thecolonel999/Word-Clock/Eagle/eagleUp/eagleUp_Word-Clock_bottom.png

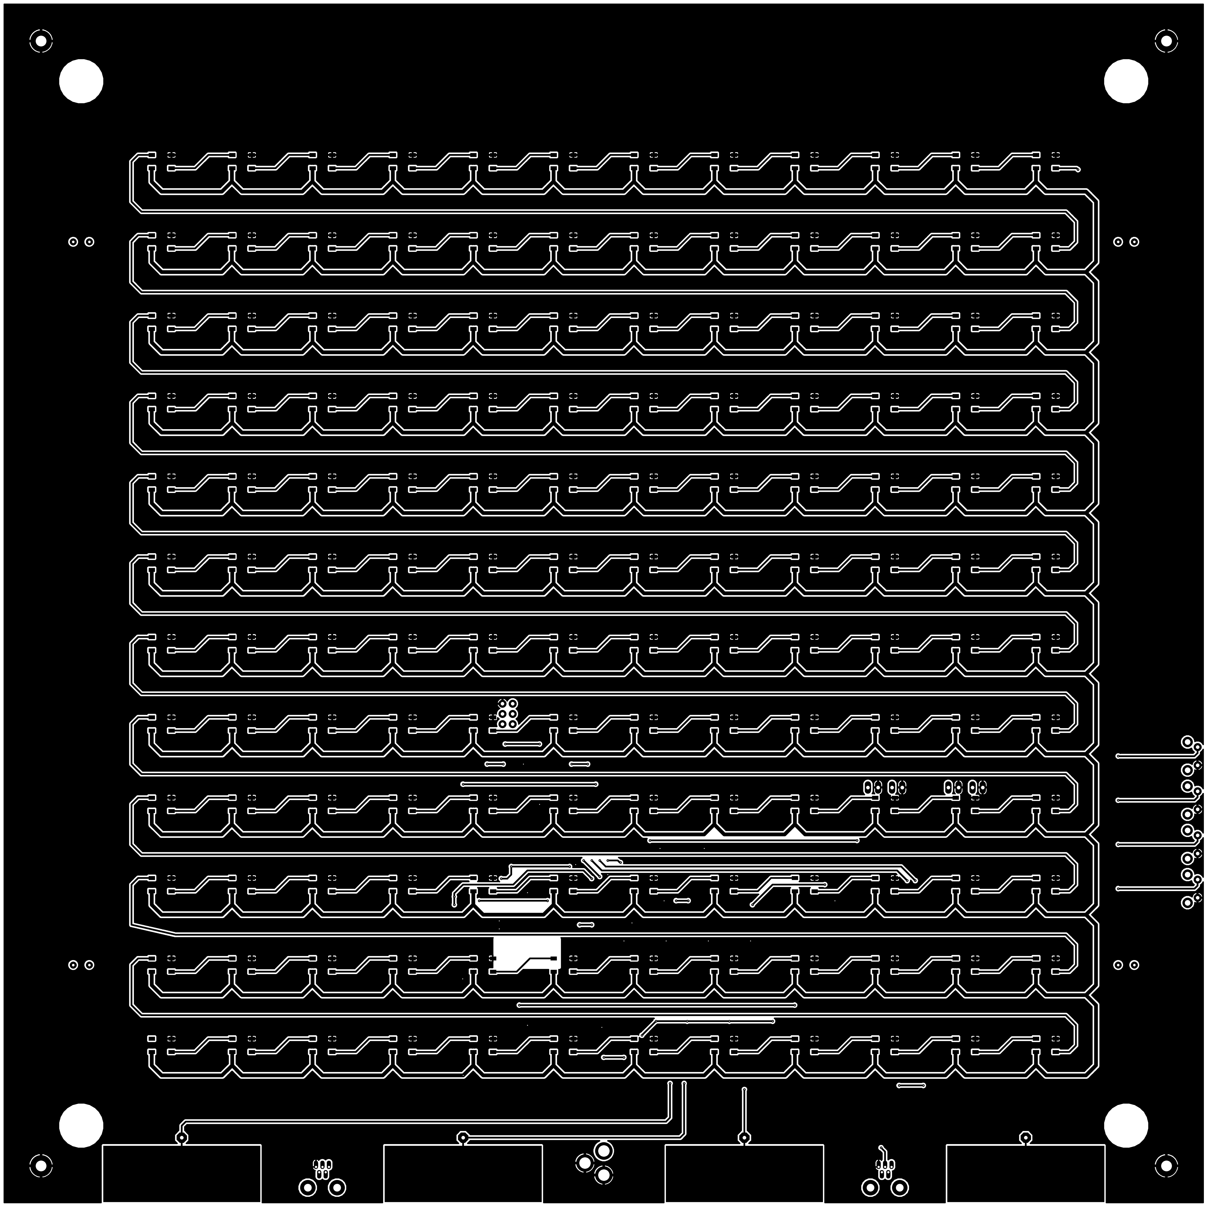
Eagle/eagleUp/eagleUp_Word-Clock_bottom.png
