thecolonel999/Word-Clock/Eagle/eagleUp/eagleUp_Word-Clock_bottom_mask.png

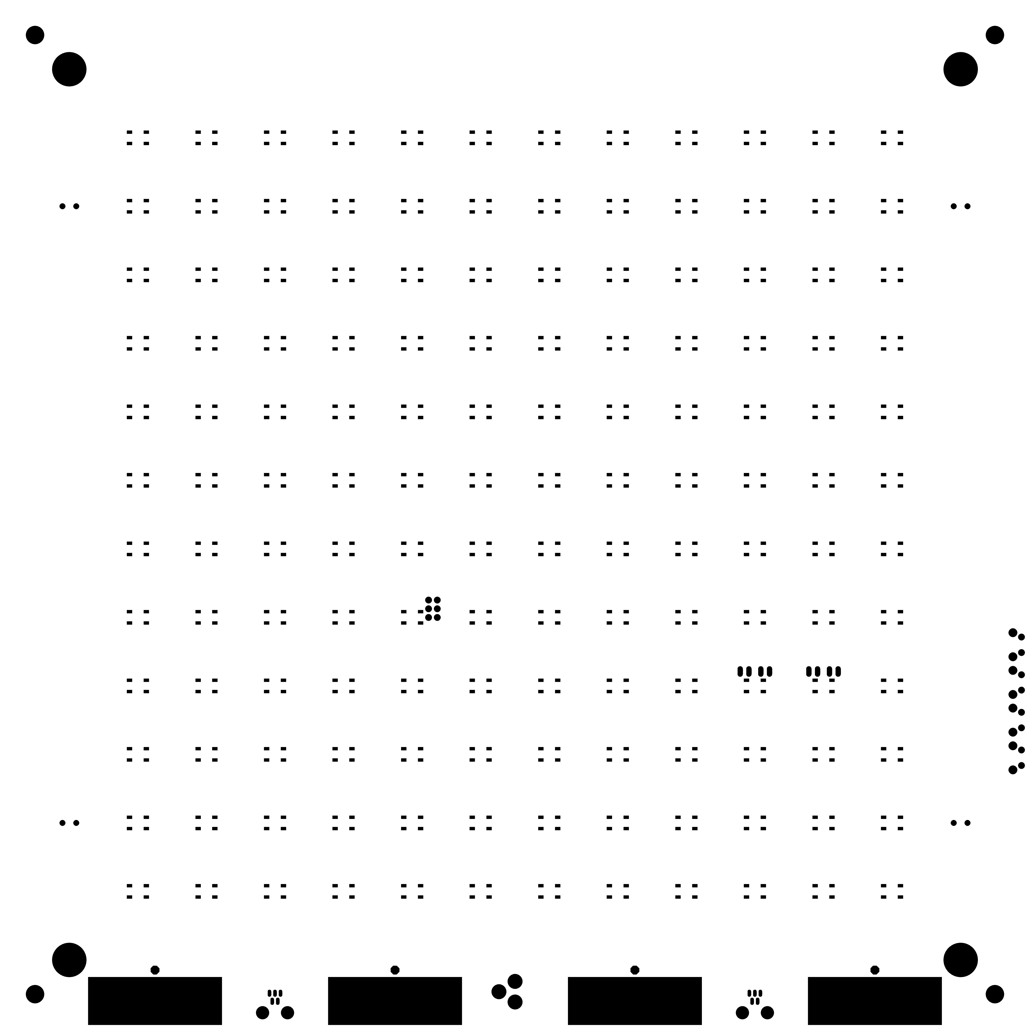
Eagle/eagleUp/eagleUp_Word-Clock_bottom_mask.png
