thecolonel999/Word-Clock/Eagle/eagleUp/eagleUp_Word-Clock_bottom_silk.png

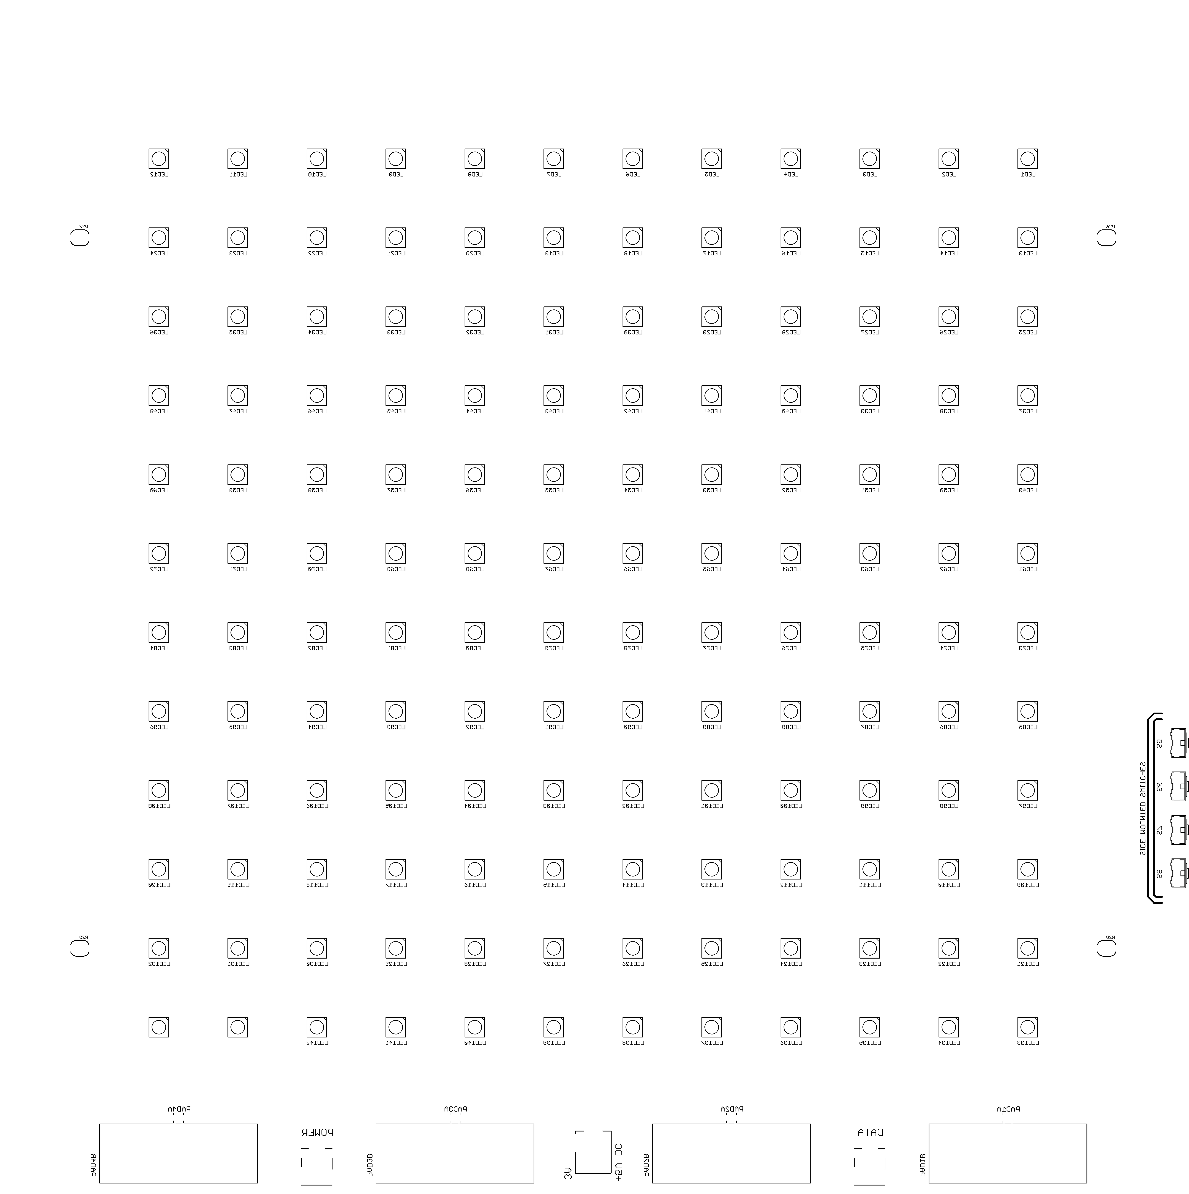
Eagle/eagleUp/eagleUp_Word-Clock_bottom_silk.png
