thecolonel999/Word-Clock/Eagle/eagleUp/eagleUp_Word-Clock_imagesize.png

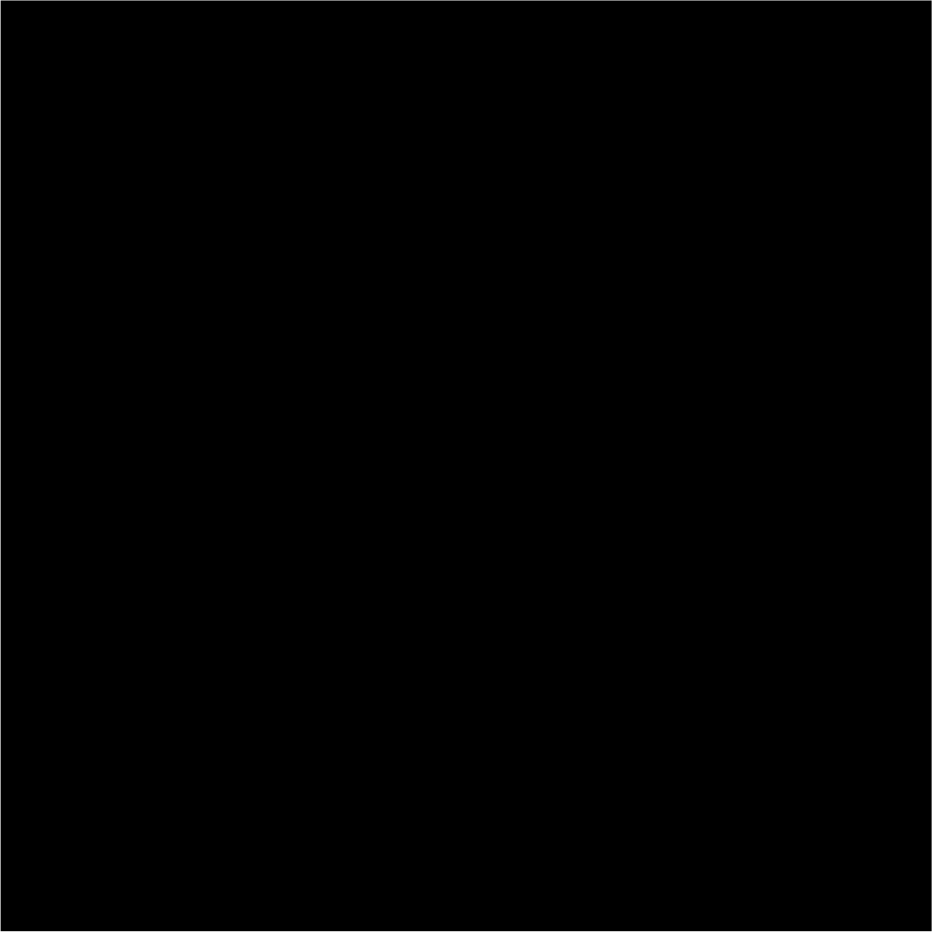
Eagle/eagleUp/eagleUp_Word-Clock_imagesize.png
