thecolonel999/Word-Clock/Eagle/eagleUp/eagleUp_Word-Clock_outline.png

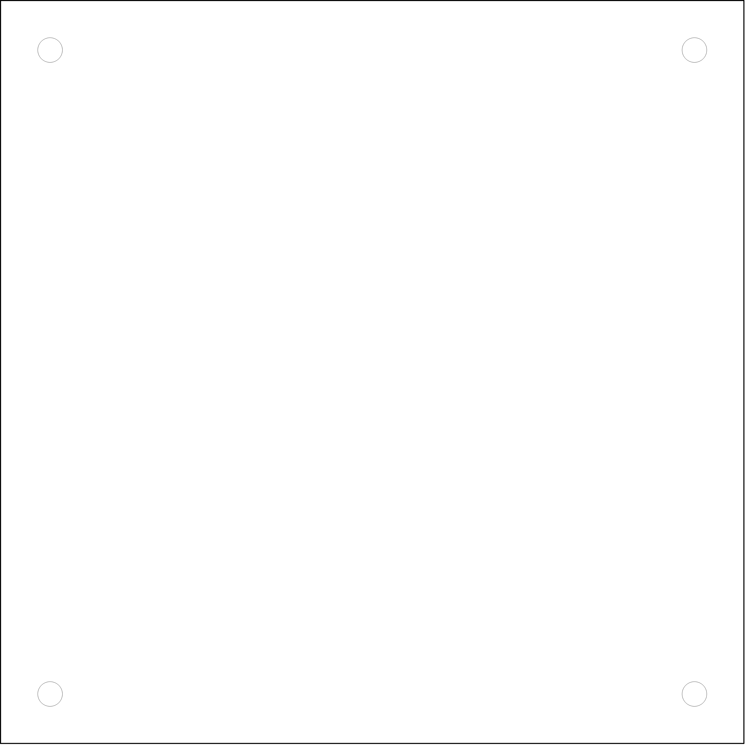
Eagle/eagleUp/eagleUp_Word-Clock_outline.png
