thecolonel999/Word-Clock/Eagle/eagleUp/eagleUp_Word-Clock_top.png

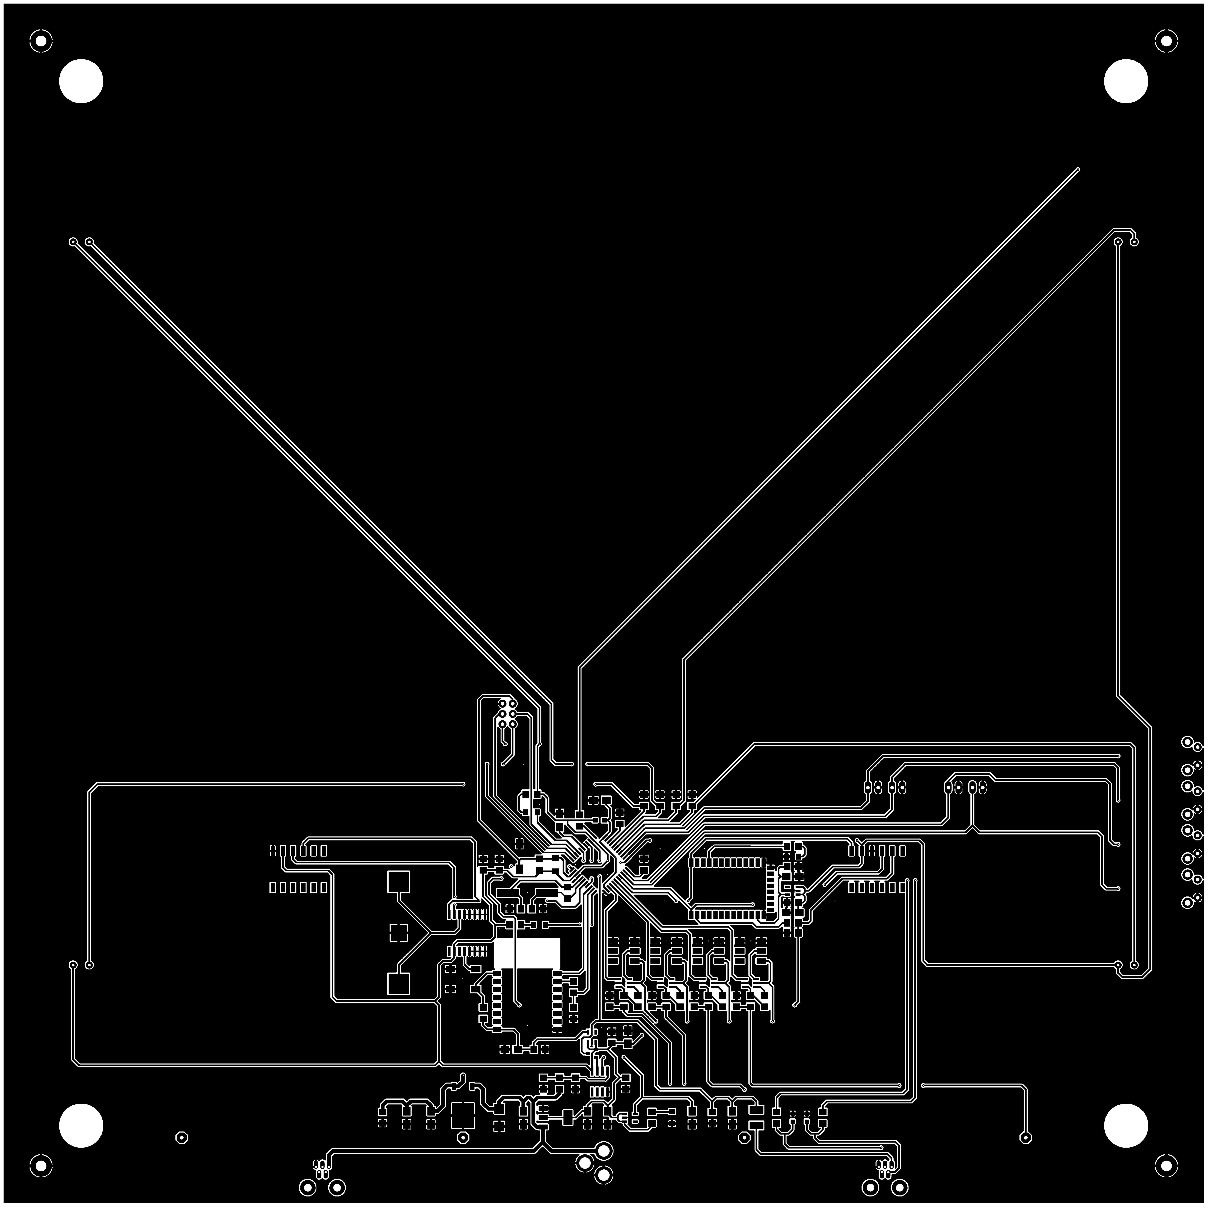
Eagle/eagleUp/eagleUp_Word-Clock_top.png
