thecolonel999/Word-Clock/Eagle/eagleUp/eagleUp_Word-Clock_top_silk.png

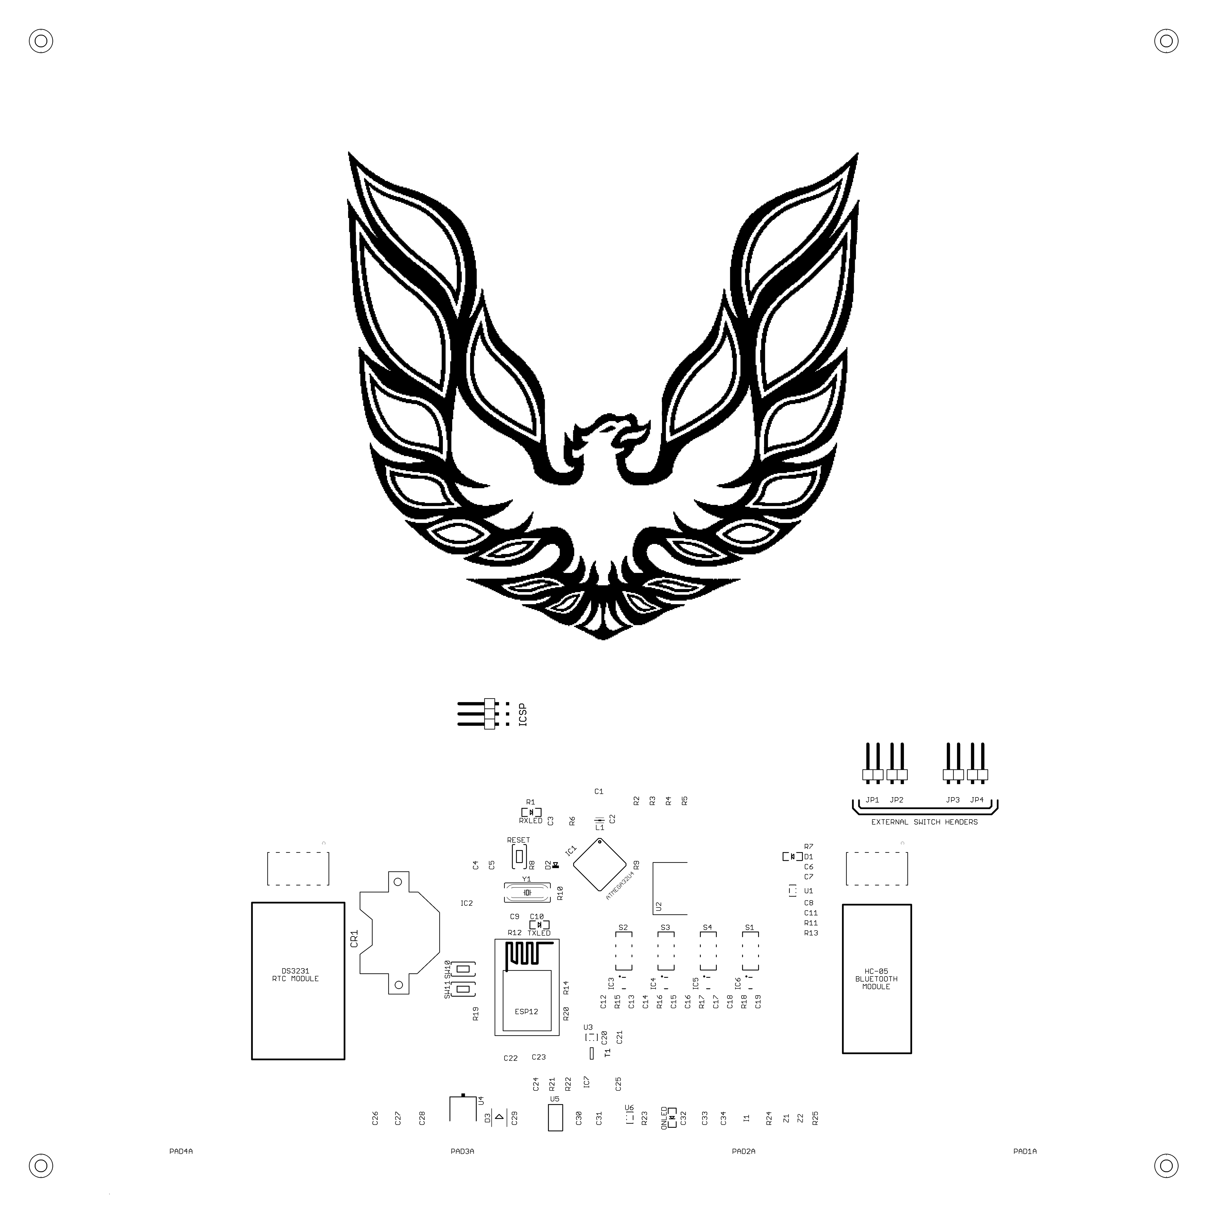
Eagle/eagleUp/eagleUp_Word-Clock_top_silk.png
