thecolonel999/Word-Clock/Sketchup Models/300mm Divider.jpg

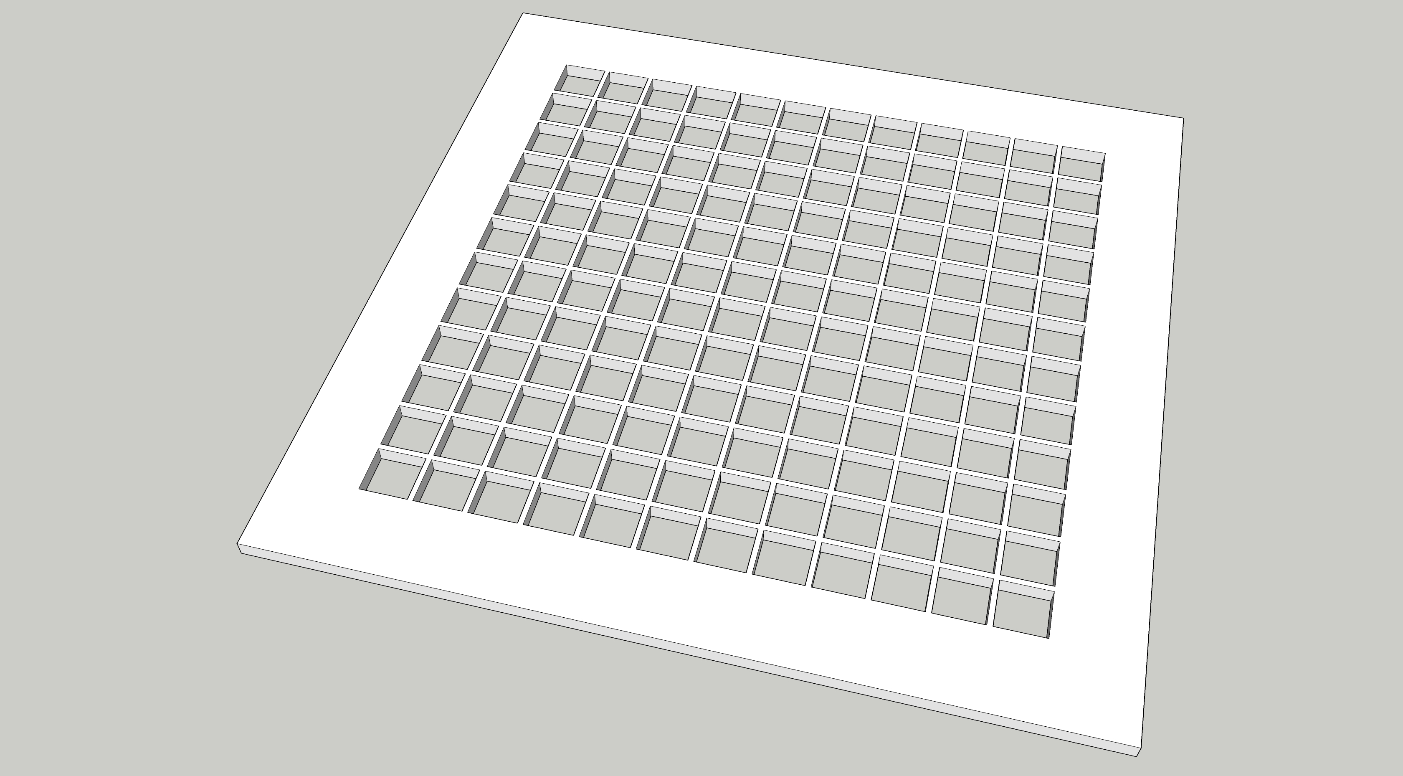
Sketchup Models/300mm Divider.jpg
