thecolonel999/Word-Clock/Vinyl Cutout/Vinyl Cutout V1.0.png

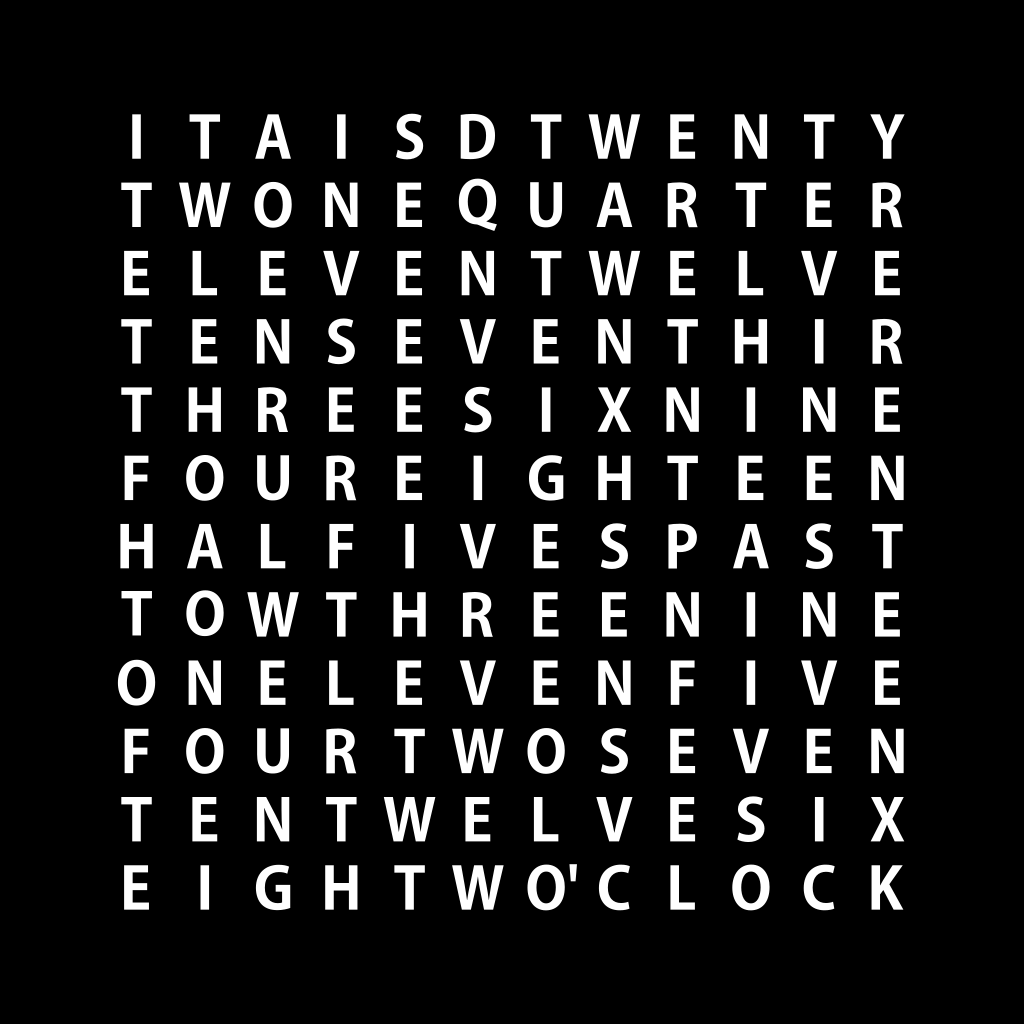
Vinyl Cutout/Vinyl Cutout V1.0.png
