thecolonel999/Word-Clock/Bill of Materials/Word-Clock-BOM.csv

Part | Value | Device | Package | Description | FARNELL | MF | MPN | OC_FARNELL | OC_NEWARK | PROD_ID | VALUE
+5VDC | POWER_JACKPTH | POWER_JACKPTH | POWER_JACK_PTH | Power Jack |  |  |  |  |  | CONN-08197
BLUETOOTH | BLUETOOTH | M06SMD-FEMALE-V2 | 1X06-SMD-FEMALE-V2 | Header 6
C1 | 1uF | CPOL-EUC/6032-28R | C/6032-28R | POLARIZED CAPACITOR, European symbol
C2 | 100n | C-EUC1206 | C1206 | CAPACITOR, European symbol
C3 | 1uF | CPOL-EUC/6032-28R | C/6032-28R | POLARIZED CAPACITOR, European symbol
C4 | 100n | C-EUC1206 | C1206 | CAPACITOR, European symbol
C5 | 100n | C-EUC1206 | C1206 | CAPACITOR, European symbol
C6 | 100n | C-EUC1206 | C1206 | CAPACITOR, European symbol
C7 | 1u | CPOL-EUSMCA | SMC_A | POLARIZED CAPACITOR, European symbol
C8 | 100n | C-EUC1206 | C1206 | CAPACITOR, European symbol
C9 | 22p | C-EUC1206 | C1206 | CAPACITOR, European symbol
C10 | 22p | C-EUC1206 | C1206 | CAPACITOR, European symbol
C11 | 1u | CPOL-EUSMCA | SMC_A | POLARIZED CAPACITOR, European symbol
C12 | 100n | C-EUC1206 | C1206 | CAPACITOR, European symbol
C13 | 100n | C-EUC1206 | C1206 | CAPACITOR, European symbol
C14 | 100n | C-EUC1206 | C1206 | CAPACITOR, European symbol
C15 | 100n | C-EUC1206 | C1206 | CAPACITOR, European symbol
C16 | 100n | C-EUC1206 | C1206 | CAPACITOR, European symbol
C17 | 100n | C-EUC1206 | C1206 | CAPACITOR, European symbol
C18 | 100n | C-EUC1206 | C1206 | CAPACITOR, European symbol
C19 | 100n | C-EUC1206 | C1206 | CAPACITOR, European symbol
C20 | 100n | C-EUC1206 | C1206 | CAPACITOR, European symbol
C21 | 1u | CPOL-EUSMCA | SMC_A | POLARIZED CAPACITOR, European symbol
C22 | 1u | CPOL-EUC/6032-28R | C/6032-28R | POLARIZED CAPACITOR, European symbol
C23 | 100n | C-EUC1206 | C1206 | CAPACITOR, European symbol
C24 | 100n | C-EUC1206 | C1206 | CAPACITOR, European symbol
C25 | 100n | C-EUC1206 | C1206 | CAPACITOR, European symbol
C26 | 100n | C-EUC1206 | C1206 | CAPACITOR, European symbol
C27 | 10u | CPOL-EUC/6032-28R | C/6032-28R | POLARIZED CAPACITOR, European symbol
C28 | 10u | CPOL-EUC/6032-28R | C/6032-28R | POLARIZED CAPACITOR, European symbol
C29 | 10u | CPOL-EUC/6032-28R | C/6032-28R | POLARIZED CAPACITOR, European symbol
C30 | 10u | CPOL-EUC/6032-28R | C/6032-28R | POLARIZED CAPACITOR, European symbol
C31 | 1u | CPOL-EUC/6032-28R | C/6032-28R | POLARIZED CAPACITOR, European symbol
C32 | 1u | CPOL-EUC/6032-28R | C/6032-28R | POLARIZED CAPACITOR, European symbol
C33 | 100n | C-EUC1206 | C1206 | CAPACITOR, European symbol
C34 | 10u | CPOL-EUC/6032-28R | C/6032-28R | POLARIZED CAPACITOR, European symbol
CR1 | CR2032 | CR2032SMT | CR2032-SMD
D1 | BLUE | LED-BLUE1206 | LED-1206 | Blue LEDs for production use |  |  |  |  |  | DIO-09911 | BLUE
D2 | CD1206-S01575 | DIODE-MINIMELF | MINIMELF | DIODE
D3 | M7 | DIODE-SMB | SMB | DIODE
DATA | USBDATA | USBMOLEX | USB-MINIB-THM-MOLEX | USB Connectors
DS1 | DS3231 | M06SMD-FEMALE-V2 | 1X06-SMD-FEMALE-V2 | Header 6
ESP1 | ESP12 | ESP-12 | ESP-12
H1 |  | MOUNT-PAD-ROUND2.8 | 2,8-PAD | MOUNTING PAD, round
H2 |  | MOUNT-PAD-ROUND2.8 | 2,8-PAD | MOUNTING PAD, round
H3 |  | MOUNT-PAD-ROUND2.8 | 2,8-PAD | MOUNTING PAD, round
H4 |  | MOUNT-PAD-ROUND2.8 | 2,8-PAD | MOUNTING PAD, round
I1 | MF-MSMF050-2 500mA | L-EUL1812 | L1812 | INDUCTOR, European symbol
IC1 | ATMEGA32U4TQFP-44 | ATMEGA32U4TQFP-44 | TQFP44 | Atmel 44-pin 8-bit Microcontroller with 32KBytes of ISP Flash and USB Controller
IC2 | DS3231/SO | DS3231/SO | SO16W
IC3 | AT42QT1010SOT23 | AT42QT1010SOT23 | SOT23-6
IC4 | AT42QT1010SOT23 | AT42QT1010SOT23 | SOT23-6
IC5 | AT42QT1010SOT23 | AT42QT1010SOT23 | SOT23-6
IC6 | AT42QT1010SOT23 | AT42QT1010SOT23 | SOT23-6
IC7 | LMV358IDGKR | LMV358MX | SO08 | Dual General Purpose, Low Voltage, Rail-to-Rail Output Operational Amplifiers
ICSP | ICSP | PINHD-2X3/90 | 2X03/90 | PIN HEADER
JP1 |  | PINHD-1X2/90 | 1X02/90 | PIN HEADER
JP2 |  | PINHD-1X2/90 | 1X02/90 | PIN HEADER
JP3 |  | PINHD-1X2/90 | 1X02/90 | PIN HEADER
JP4 |  | PINHD-1X2/90 | 1X02/90 | PIN HEADER
L1 | MH2029-300Y | WE-CBF_0805 | 0805 | SMD EMI Suppression Ferrite Beads
LED1 | WS2812B | WS2812B | WS2812B
LED2 | WS2812B | WS2812B | WS2812B
LED3 | WS2812B | WS2812B | WS2812B
LED4 | WS2812B | WS2812B | WS2812B
LED5 | WS2812B | WS2812B | WS2812B
LED6 | WS2812B | WS2812B | WS2812B
LED7 | WS2812B | WS2812B | WS2812B
LED8 | WS2812B | WS2812B | WS2812B
LED9 | WS2812B | WS2812B | WS2812B
LED10 | WS2812B | WS2812B | WS2812B
LED11 | WS2812B | WS2812B | WS2812B
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
R27 | PHOTOCELLPTH | PHOTOCELLPTH | PHOTOCELL | CdS photoresistor. This is a low cost way to detect light levels. Resistance decreases with more incoming light. SparkFun SKU: SEN-09088
R28 | PHOTOCELLPTH | PHOTOCELLPTH | PHOTOCELL | CdS photoresistor. This is a low cost way to detect light levels. Resistance decreases with more incoming light. SparkFun SKU: SEN-09088
R29 | PHOTOCELLPTH | PHOTOCELLPTH | PHOTOCELL | CdS photoresistor. This is a low cost way to detect light levels. Resistance decreases with more incoming light. SparkFun SKU: SEN-09088
RESET | SWITCH-MOMENTARY-2SMD-1101NE | SWITCH-MOMENTARY-2SMD-1101NE | TACTILE-SWITCH-1101NE | Various NO switches- pushbuttons, reed, etc |  |  |  |  |  | 1703878
RXLED | GREEN | LED-GREEN1206 | LED-1206 | Various green LEDs | 2322085 |  |  |  |  | DIO-00862 | GREEN
S1 | JS202011SCQN | JS202011SCQN | JS202011SCQN | DPDT SLIDE SWITCH
S2 | JS202011SCQN | JS202011SCQN | JS202011SCQN | DPDT SLIDE SWITCH
S3 | JS202011SCQN | JS202011SCQN | JS202011SCQN | DPDT SLIDE SWITCH
S4 | JS202011SCQN | JS202011SCQN | JS202011SCQN | DPDT SLIDE SWITCH
SW1 | SWITCH-MOMENTARY-2SIDE_EZ | SWITCH-MOMENTARY-2SIDE_EZ | TACTILE-PTH-SIDEEZ | Various NO switches- pushbuttons, reed, etc
SW2 | SWITCH-MOMENTARY-2SIDE_EZ | SWITCH-MOMENTARY-2SIDE_EZ | TACTILE-PTH-SIDEEZ | Various NO switches- pushbuttons, reed, etc
SW3 | SWITCH-MOMENTARY-2SIDE_EZ | SWITCH-MOMENTARY-2SIDE_EZ | TACTILE-PTH-SIDEEZ | Various NO switches- pushbuttons, reed, etc
SW4 | SWITCH-MOMENTARY-2SIDE_EZ | SWITCH-MOMENTARY-2SIDE_EZ | TACTILE-PTH-SIDEEZ | Various NO switches- pushbuttons, reed, etc
SW10 | SWITCH-MOMENTARY-2SMD-1101NE | SWITCH-MOMENTARY-2SMD-1101NE | TACTILE-SWITCH-1101NE | Various NO switches- pushbuttons, reed, etc |  |  |  |  |  | 1703878
SW11 | SWITCH-MOMENTARY-2SMD-1101NE | SWITCH-MOMENTARY-2SMD-1101NE | TACTILE-SWITCH-1101NE | Various NO switches- pushbuttons, reed, etc |  |  |  |  |  | 1703878
T1 | FDN340P | PMOSSOT23 | SOT-23 | MOS FET |  |  |  | unknown | unknown
TXLED | RED | LED-RED1206 | LED-1206 | Assorted Red LEDs |  |  |  |  |  | DIO-09912 | RED
U1 | LP2985-33DBVR | LP2985-XXDBVR33 | SOT23-DBV | ULTRALOW-POWER 50-mA LOW-DROPOUT LINEAR REGULATORS
U2 | HC_05 | HC_05 | BLUETOOTH_SMD
U3 | LP2985-33DBVR | LP2985-XXDBVR33 | SOT23-DBV | ULTRALOW-POWER 50-mA LOW-DROPOUT LINEAR REGULATORS
U4 | +12v | V_REG_78XX7812 | TO-252 | Voltage Regulator |  |  |  |  |  | VREG-12370 | +12v
U5 | NCP1117ST50T3G | MC33269ST-3.3T3 | SOT223 | Adjustable Output Low Dropout Voltage Regulator 800 mA | 1147874
U6 | LP2985-33DBVR | LP2985-XXDBVR33 | SOT23-DBV | ULTRALOW-POWER 50-mA LOW-DROPOUT LINEAR REGULATORS
Y1 | 16MHz | CRYSTALSMD | HC49UP | Various standard crystals. Proven footprints.
Z1 | CG0603MLC-05E | VARISTORCN0603 | CT/CN0603 | VARISTOR
Z2 | CG0603MLC-05E | VARISTORCN0603 | CT/CN0603 | VARISTOR
