thecolonel999/Word-Clock/Bill of Materials/Word-Clock-BOM.xlsx

Sheet: Word-Clock
Part | Value | Device | Package | Price | Currency | GST? |  | $AUD | Supplier | Manufacturer Part Number
C1 | 100uF | CPOL-EUE2.5-6 | E2 | $0.02 | $USD | Yes |  | $0.02 | Tayda
C2 | 100nF | C5/2.5 | C5B2.5 | $0.01 |  | Yes |  | $0.01 | Tayda
C3 | 100uF | CPOL-EUE2.5-6 | E2 | $0.02 |  | Yes |  | $0.02 | Tayda
C4 | 100nF | C5/2.5 | C5B2.5 | $0.01 |  | Yes |  | $0.01 | Tayda
C5 | 100uF | CPOL-EUE2.5-6 | E2 | $0.02 |  | Yes |  | $0.02 | Tayda
C6 | 100nF | C5/2.5 | C5B2.5 | $0.01 |  | Yes |  | $0.01 | Tayda
C7 | 100nF | C5/2.5 | C5B2.5 | $0.01 |  | Yes |  | $0.01 | Tayda
C9 | 100nF | C5/2.5 | C5B2.5 | $0.01 |  | Yes |  | $0.01 | Tayda
C10 | 100nF | C5/2.5 | C5B2.5 | $0.01 |  | Yes |  | $0.01 | Tayda
C11 | 1uF | CPOL-EUE2.5-6 | E2 | $0.02 |  | Yes |  | $0.02 | Tayda
C12 | 100nF | C5/2.5 | C5B2.5 | $0.01 |  | Yes |  | $0.01 | Tayda
C13 | 1uF | CPOL-EUE2.5-6 | E2 | $0.02 |  | Yes |  | $0.02 | Tayda
C14 | 22pF | C-EU050-024X044 | C050-024X044 | $0.01 |  | Yes |  | $0.01 | Tayda
C15 | 22pF | C-EU050-024X044 | C050-024X044 | $0.01 |  | Yes |  | $0.01 | Tayda
D1 | 1N4001 | 1N4004 | DO41-10 | $0.00 |  | Yes |  | $0.00 | -
D2 | 1N4148 | 1N4148DO35-7 | DO35-7 | $0.00 |  | Yes |  | $0.00 | -
D3 |  | LED1206 | LED-1206 | $0.00 |  | Yes |  | $0.00 | Ace Electronics
D4 |  | LED1206 | LED-1206 | $0.00 |  | Yes |  | $0.00 | Ace Electronics
F1 | 500mA | PTCFUSE-1206 | R1206 | $0.10 |  | Yes |  | $0.10 | Tayda
G1 | CR2032H | CR2032H | CR2032H | $0.10 |  | Yes |  | $0.10 | Tayda
I1 |  | L-EU0207/7 | 0207/7 | $0.08 |  | Yes |  | $0.08 | Tayda
IC2 | LM2936Z-3.3 | LM2936Z-3.3 | TO92 | $0.18 |  | Yes |  | $0.18 | Tayda | LP2950-33LPE3
IC3 | LM358N | LM358N | DIL08 | $0.00 |  | Yes |  | $0.00 | On Hand
IC4 | DS3231/SO | DS3231/SO | SO16W | $11.13 |  | No | 10% | $12.24 | RS Components
IC5 | LM340H-05 | LM340H-05 | TO220H | $2.46 |  | No | 10% | $2.71 | RS Components | LM1085IT-5.0/NOPB
JP1 |  | M03X2SHROUD | 2X3-SHROUDED | $0.92 |  | No |  | $0.92 | RS Components | T821106A1S100CEU
JP2 | USBPTH-VERTICAL | USBPTH-VERTICAL | USB-B-PTH-VERTICAL | $1.59 |  | Yes |  | $1.59 | Element 14 | M701-330442
JP3 |  | M03X2SHROUD | 2X3-SHROUDED | $0.92 |  | No |  | $0.92 | RS Components | T821106A1S100CEU
JP4 |  | M02POLAR | MOLEX-1X2 | $0.02 |  | Yes |  | $0.02 | Tayda | 22-23-5024
JP5 |  | M02POLAR | MOLEX-1X2 | $0.02 |  | Yes |  | $0.02 | Tayda | 22-23-5024
JP6 |  | M02POLAR | MOLEX-1X2 | $0.02 |  | Yes |  | $0.02 | Tayda | 22-23-5024
LED1 | WS2812B | WS2812B | WS2812B | $0.27 |  |  |  | $0.27 | http://www.aliexpress.com/item/New-500PCS-APA102C-LED-Chips-APA102-Built-in-5050-RGB-LED-Individual-Addressable/2003779839.html
LED2 | WS2812B | WS2812B | WS2812B | $0.27 |  |  |  | $0.27
LED3 | WS2812B | WS2812B | WS2812B | $0.27 |  |  |  | $0.27
LED4 | WS2812B | WS2812B | WS2812B | $0.27 |  |  |  | $0.27
LED5 | WS2812B | WS2812B | WS2812B | $0.27 |  |  |  | $0.27
LED6 | WS2812B | WS2812B | WS2812B | $0.27 |  |  |  | $0.27
LED7 | WS2812B | WS2812B | WS2812B | $0.27 |  |  |  | $0.27
LED8 | WS2812B | WS2812B | WS2812B | $0.27 |  |  |  | $0.27
LED9 | WS2812B | WS2812B | WS2812B | $0.27 |  |  |  | $0.27
LED10 | WS2812B | WS2812B | WS2812B | $0.27 |  |  |  | $0.27
LED11 | WS2812B | WS2812B | WS2812B | $0.27 |  |  |  | $0.27
LED12 | WS2812B | WS2812B | WS2812B | $0.27 |  |  |  | $0.27
LED13 | WS2812B | WS2812B | WS2812B | $0.27 |  |  |  | $0.27
LED14 | WS2812B | WS2812B | WS2812B | $0.27 |  |  |  | $0.27
LED15 | WS2812B | WS2812B | WS2812B | $0.27 |  |  |  | $0.27
LED16 | WS2812B | WS2812B | WS2812B | $0.27 |  |  |  | $0.27
LED17 | WS2812B | WS2812B | WS2812B | $0.27 |  |  |  | $0.27
LED18 | WS2812B | WS2812B | WS2812B | $0.27 |  |  |  | $0.27
LED19 | WS2812B | WS2812B | WS2812B | $0.27 |  |  |  | $0.27
LED20 | WS2812B | WS2812B | WS2812B | $0.27 |  |  |  | $0.27
LED21 | WS2812B | WS2812B | WS2812B | $0.27 |  |  |  | $0.27
LED22 | WS2812B | WS2812B | WS2812B | $0.27 |  |  |  | $0.27
LED23 | WS2812B | WS2812B | WS2812B | $0.27 |  |  |  | $0.27
LED24 | WS2812B | WS2812B | WS2812B | $0.27 |  |  |  | $0.27
LED25 | WS2812B | WS2812B | WS2812B | $0.27 |  |  |  | $0.27
LED26 | WS2812B | WS2812B | WS2812B | $0.27 |  |  |  | $0.27
LED27 | WS2812B | WS2812B | WS2812B | $0.27 |  |  |  | $0.27
LED28 | WS2812B | WS2812B | WS2812B | $0.27 |  |  |  | $0.27
LED29 | WS2812B | WS2812B | WS2812B | $0.27 |  |  |  | $0.27
LED30 | WS2812B | WS2812B | WS2812B | $0.27 |  |  |  | $0.27
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
R4 | PHOTOCELLPTH | PHOTOCELLPTH | PHOTOCELL | $0.24 | Tayda |  |  | $0.24
R5 | 10k | R-EU_0207/7 | 0207/7 | $0.00 |  |  |  | $0.00
R6 | 22R | R-EU_0207/7 | 0207/7 | $0.00 |  |  |  | $0.00
R7 | 22R | R-EU_0207/7 | 0207/7 | $0.00 |  |  |  | $0.00
R8 | 1M | R-EU_0207/7 | 0207/7 | $0.00 |  |  |  | $0.00
R9 | 10k | R-EU_0207/7 | 0207/7 | $0.00 |  |  |  | $0.00
R10 | 1K | R-EU_0207/7 | 0207/7 | $0.00 |  |  |  | $0.00
R11 | 1K | R-EU_0207/7 | 0207/7 | $0.00 |  |  |  | $0.00
R12 | PHOTOCELLPTH | PHOTOCELLPTH | PHOTOCELL | $0.24 | Tayda |  |  | $0.24
R13 | 10k | R-EU_0207/7 | 0207/7 | $0.00 |  |  |  | $0.00
R14 | PHOTOCELLPTH | PHOTOCELLPTH | PHOTOCELL | $0.24 | Tayda |  |  | $0.24
R15 | 10k | R-EU_0207/7 | 0207/7 | $0.00 |  |  |  | $0.00
R16 | PHOTOCELLPTH | PHOTOCELLPTH | PHOTOCELL | $0.24 | Tayda |  |  | $0.24
R17 | 10k | R-EU_0207/7 | 0207/7 | $0.00 |  |  |  | $0.00
S1 |  | SWITCH-MOMENTARY-2PTH | TACTILE-PTH | $0.10 |  |  |  | $0.10
U1 | ATMEGA32U4TQFP-44 | ATMEGA32U4TQFP-44 | TQFP44 | $8.63 |  |  |  | $8.63
Y1 | 16MHz | CRYSTALHC49UV | HC49U-V | $0.10 |  |  |  | $0.10
 |  |  |  | $65.92 |  |  |  | $67.28

Sheet: Sheet1
 | Cost | Supplier
Frame | $14.95 | http://www.ikea.com/aa/en/catalog/products/80208138/
 | $12.95 | http://www.ikea.com/aa/en/catalog/products/70221913/
Glass |  | http://www.balcattaglass.com.au/
Decal
Acrylic Dividers |  | https://www.ponoko.com
