thecolonel999/Word-Clock/Laser DXF/300mm Divider (no side switches) Bottom.dxf

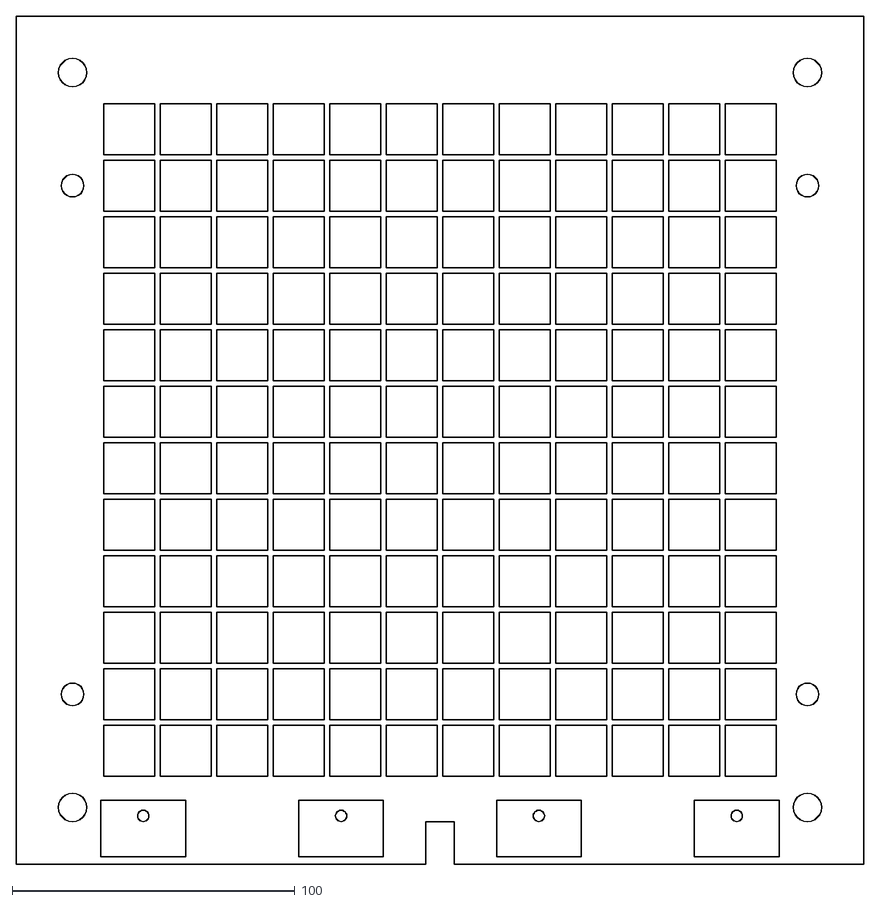
[picture p17: CAD file, 2020-06-25]
Laser DXF/300mm Divider (no side switches) Bottom.dxf
300.0 x 300.0
