thecolonel999/Word-Clock/Vinyl Cutout/Vinyl Cutout V1.0.dxf

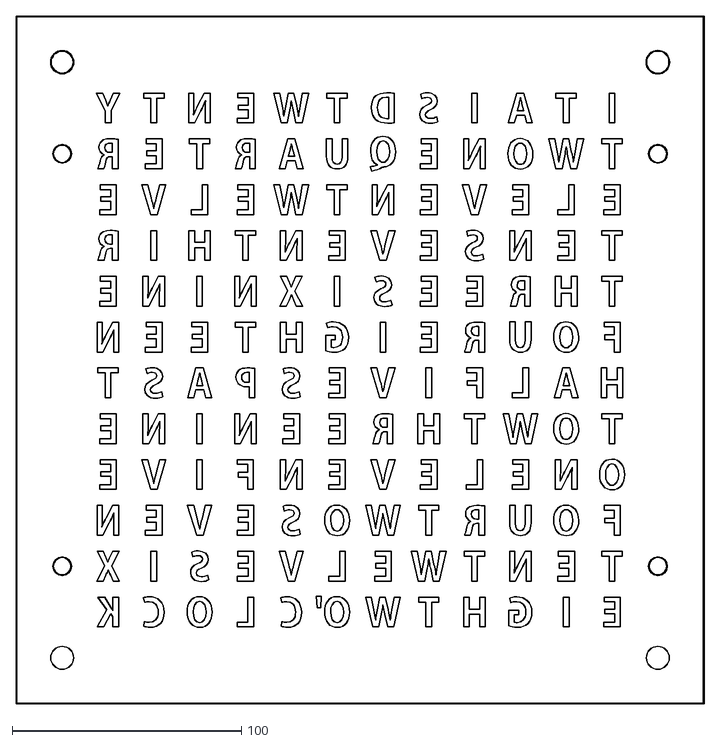
[picture p18: CAD file, 2020-06-25]
Vinyl Cutout/Vinyl Cutout V1.0.dxf
300.3 x 300.3
