thecolonel999/Word-Clock/(list of files, cad)

Other CAD files:
Sketchup Models/230mm Divider.skp
Sketchup Models/300mm Divider (no side switches).skp
Sketchup Models/300mm Divider (no side switches)~.skp
Sketchup Models/300mm Divider.skp
Sketchup Models/300mm Divider~.skp
Sketchup Models/Back Panel.skp
Sketchup Models/Glass.skp
