thecolonel999/Word-Clock/Operating Cost Calcs.xlsx

Sheet: Hours
0:00:00 | TWELVE | 6
1:00:00 | ONE | 3
2:00:00 | TWO | 3
3:00:00 | THREE | 5
4:00:00 | FOUR | 4
5:00:00 | FIVE | 4
6:00:00 | SIX | 3
7:00:00 | SEVEN | 5
8:00:00 | EIGHT | 5
9:00:00 | NINE | 4
10:00:00 | TEN | 3
11:00:00 | ELEVEN | 6
12:00:00 | TWELVE | 6
13:00:00 | ONE | 3
14:00:00 | TWO | 3
15:00:00 | THREE | 5
16:00:00 | FOUR | 4
17:00:00 | FIVE | 4
18:00:00 | SIX | 3
19:00:00 | SEVEN | 5
20:00:00 | EIGHT | 5
21:00:00 | NINE | 4
22:00:00 | TEN | 3
23:00:00 | ELEVEN | 6
 |  | 102

Sheet: Minutes
 |  |  |  | 1 MIN |  | 5 MIN |  | 15 MIN
0:00:00 |  |  | 0 | YES | 0 | YES | 0 | YES | 0
0:01:00 | ONE | PAST | 7 | YES | 7 | NO | 0 | NO | 0
0:02:00 | TWO | PAST | 7 | YES | 7 | NO | 0 | NO | 0
0:03:00 | THREE | PAST | 9 | YES | 9 | NO | 0 | NO | 0
0:04:00 | FOUR | PAST | 8 | YES | 8 | NO | 0 | NO | 0
0:05:00 | FIVE | PAST | 8 | YES | 8 | YES | 8 | NO | 0
0:06:00 | SIX | PAST | 7 | YES | 7 | NO | 0 | NO | 0
0:07:00 | SEVEN | PAST | 9 | YES | 9 | NO | 0 | NO | 0
0:08:00 | EIGHT | PAST | 9 | YES | 9 | NO | 0 | NO | 0
0:09:00 | NINE | PAST | 8 | YES | 8 | NO | 0 | NO | 0
0:10:00 | TEN | PAST | 7 | YES | 7 | YES | 7 | NO | 0
0:11:00 | ELEVEN | PAST | 10 | YES | 10 | NO | 0 | NO | 0
0:12:00 | TWELVE | PAST | 10 | YES | 10 | NO | 0 | NO | 0
0:13:00 | THIRTEEN | PAST | 12 | YES | 12 | NO | 0 | NO | 0
0:14:00 | FOURTEEN | PAST | 12 | YES | 12 | NO | 0 | NO | 0
0:15:00 | QUARTER | PAST | 11 | YES | 11 | YES | 11 | YES | 11
0:16:00 | SIXTEEN | PAST | 11 | YES | 11 | NO | 0 | NO | 0
0:17:00 | SEVENTEEN | PAST | 13 | YES | 13 | NO | 0 | NO | 0
0:18:00 | EIGHTEEN | PAST | 12 | YES | 12 | NO | 0 | NO | 0
0:19:00 | NINETEEN | PAST | 12 | YES | 12 | NO | 0 | NO | 0
0:20:00 | TWENTY | PAST | 10 | YES | 10 | YES | 10 | NO | 0
0:21:00 | TWENTY ONE | PAST | 13 | YES | 13 | NO | 0 | NO | 0
0:22:00 | TWENTY TWO | PAST | 13 | YES | 13 | NO | 0 | NO | 0
0:23:00 | TWENTY THREE | PAST | 15 | YES | 15 | NO | 0 | NO | 0
0:24:00 | TWENTY FOUR | PAST | 14 | YES | 14 | NO | 0 | NO | 0
0:25:00 | TWENTY FIVE | PAST | 14 | YES | 14 | YES | 14 | NO | 0
0:26:00 | TWENTY SIX | PAST | 13 | YES | 13 | NO | 0 | NO | 0
0:27:00 | TWENTY SEVEN | PAST | 15 | YES | 15 | NO | 0 | NO | 0
0:28:00 | TWENTY EIGHT | PAST | 15 | YES | 15 | NO | 0 | NO | 0
0:29:00 | TWENTY NINE | PAST | 14 | YES | 14 | NO | 0 | NO | 0
0:30:00 | HALF | PAST | 8 | YES | 8 | YES | 8 | YES | 8
0:31:00 | TWENTY NINE | TO | 12 | YES | 12 | NO | 0 | NO | 0
0:32:00 | TWENTY EIGHT | TO | 13 | YES | 13 | NO | 0 | NO | 0
0:33:00 | TWENTY SEVEN | TO | 13 | YES | 13 | NO | 0 | NO | 0
0:34:00 | TWENTY SIX | TO | 11 | YES | 11 | NO | 0 | NO | 0
0:35:00 | TWENTY FIVE | TO | 12 | YES | 12 | YES | 12 | NO | 0
0:36:00 | TWENTY FOUR | TO | 12 | YES | 12 | NO | 0 | NO | 0
0:37:00 | TWENTY THREE | TO | 13 | YES | 13 | NO | 0 | NO | 0
0:38:00 | TWENTY TWO | TO | 11 | YES | 11 | NO | 0 | NO | 0
0:39:00 | TWENTY ONE | TO | 11 | YES | 11 | NO | 0 | NO | 0
0:40:00 | TWENTY | TO | 8 | YES | 8 | YES | 8 | NO | 0
0:41:00 | NINETEEN | TO | 10 | YES | 10 | NO | 0 | NO | 0
0:42:00 | EIGHTEEN | TO | 10 | YES | 10 | NO | 0 | NO | 0
0:43:00 | SEVENTEEN | TO | 11 | YES | 11 | NO | 0 | NO | 0
0:44:00 | SIXTEEN | TO | 9 | YES | 9 | NO | 0 | NO | 0
0:45:00 | QUARTER | TO | 9 | YES | 9 | YES | 9 | YES | 9
0:46:00 | FOURTEEN | TO | 10 | YES | 10 | NO | 0 | NO | 0
0:47:00 | THIRTEEN | TO | 10 | YES | 10 | NO | 0 | NO | 0
0:48:00 | TWELVE | TO | 8 | YES | 8 | NO | 0 | NO | 0
0:49:00 | ELEVEN | TO | 8 | YES | 8 | NO | 0 | NO | 0
0:50:00 | TEN | TO | 5 | YES | 5 | YES | 5 | NO | 0
0:51:00 | NINE | TO | 6 | YES | 6 | NO | 0 | NO | 0
0:52:00 | EIGHT | TO | 7 | YES | 7 | NO | 0 | NO | 0
0:53:00 | SEVEN | TO | 7 | YES | 7 | NO | 0 | NO | 0
0:54:00 | SIX | TO | 5 | YES | 5 | NO | 0 | NO | 0
0:55:00 | FIVE | TO | 6 | YES | 6 | YES | 6 | NO | 0
0:56:00 | FOUR | TO | 6 | YES | 6 | NO | 0 | NO | 0
0:57:00 | THREE | TO | 7 | YES | 7 | NO | 0 | NO | 0
0:58:00 | TWO | TO | 5 | YES | 5 | NO | 0 | NO | 0
0:59:00 | ONE | TO | 5 | YES | 5 | NO | 0 | NO | 0
 |  |  |  |  | 586 |  | 98 |  | 28

Sheet: TOTAL
HOUR | IT IS | MINUTES PAST/TO | HOUR | O'CLOCK | TOTAL LED SECS | PERIOD | BRIGHTNESS (%) | FADE IN | ON | FADE OUT | TOTAL | TOTAL EQUIV LED SECS | mAh
0:00:00 | 16 | 28 | 24 | 6 | 4440 | 15 | 50% | 2 | 6 | 2 | 10 | 296 | 4.93
1:00:00 | 16 | 28 | 12 | 6 | 3720 | 15 | 50% | 2 | 6 | 2 | 10 | 248 | 4.13
2:00:00 | 16 | 28 | 12 | 6 | 3720 | 15 | 50% | 2 | 6 | 2 | 10 | 248 | 4.13
3:00:00 | 16 | 28 | 20 | 6 | 4200 | 15 | 50% | 2 | 6 | 2 | 10 | 280 | 4.67
4:00:00 | 16 | 28 | 16 | 6 | 3960 | 15 | 50% | 2 | 6 | 2 | 10 | 264 | 4.40
5:00:00 | 48 | 98 | 48 | 6 | 12000 | 5 | 60% | 2 | 56 | 2 | 60 | 6960 | 116.00
6:00:00 | 240 | 586 | 180 | 6 | 60720 | 1 | 70% | 2 | 56 | 2 | 60 | 41087.2 | 684.79
7:00:00 | 240 | 586 | 300 | 6 | 67920 | 1 | 80% | 2 | 56 | 2 | 60 | 52524.8 | 875.41
8:00:00 | 240 | 586 | 300 | 6 | 67920 | 1 | 90% | 2 | 56 | 2 | 60 | 59090.4 | 984.84
9:00:00 | 240 | 586 | 240 | 6 | 64320 | 1 | 100% | 2 | 56 | 2 | 60 | 62176 | 1036.27
10:00:00 | 48 | 98 | 36 | 6 | 11280 | 5 | 100% | 2 | 56 | 2 | 60 | 10904 | 181.73
11:00:00 | 48 | 98 | 72 | 6 | 13440 | 5 | 100% | 2 | 56 | 2 | 60 | 12992 | 216.53
12:00:00 | 48 | 98 | 72 | 6 | 13440 | 5 | 100% | 2 | 56 | 2 | 60 | 12992 | 216.53
13:00:00 | 48 | 98 | 36 | 6 | 11280 | 5 | 100% | 2 | 56 | 2 | 60 | 10904 | 181.73
14:00:00 | 48 | 98 | 36 | 6 | 11280 | 5 | 100% | 2 | 56 | 2 | 60 | 10904 | 181.73
15:00:00 | 48 | 98 | 60 | 6 | 12720 | 5 | 100% | 2 | 56 | 2 | 60 | 12296 | 204.93
16:00:00 | 240 | 586 | 240 | 6 | 64320 | 1 | 100% | 2 | 56 | 2 | 60 | 62176 | 1036.27
17:00:00 | 240 | 586 | 240 | 6 | 64320 | 1 | 100% | 2 | 56 | 2 | 60 | 62176 | 1036.27
18:00:00 | 240 | 586 | 180 | 6 | 60720 | 1 | 100% | 2 | 56 | 2 | 60 | 58696 | 978.27
19:00:00 | 240 | 586 | 300 | 6 | 67920 | 1 | 90% | 2 | 56 | 2 | 60 | 59090.4 | 984.84
20:00:00 | 240 | 586 | 300 | 6 | 67920 | 1 | 75% | 2 | 56 | 2 | 60 | 49242 | 820.70
21:00:00 | 48 | 98 | 48 | 6 | 12000 | 5 | 50% | 2 | 56 | 2 | 60 | 5800 | 96.67
22:00:00 | 48 | 98 | 36 | 6 | 11280 | 5 | 50% | 2 | 56 | 2 | 60 | 5452 | 90.87
23:00:00 | 16 | 28 | 24 | 6 | 4440 | 15 | 50% | 2 | 6 | 2 | 10 | 296 | 4.93
 |  |  |  |  |  |  |  |  |  |  |  |  | 9951.58
 |  |  | MAX | ACTUAL
LED OPERATING SECONDS PER DAY: |  |  | 1565280 | 597094.8
TOTAL SECONDS PER DAY (24*60*60): |  |  | 86400 | 86400
AVG LED'S PER SECOND: |  |  | 18.11666667 | 6.910819444
CURRENT DRAW PER LED (mA): |  |  | 60 | 60
AVERAGE CURRENT DRAWN (A): |  |  | 1.087 | 0.4146491667
OPERATING VOLTAGE (V): |  |  | 5 | 5
TOTAL POWER DRAWN (W): |  |  | 5.435 | 2.073245833
kWh PER YEAR: |  |  | 47.6106 | 18.1616335
PRICE PER kWh © |  |  | $0.257029 | $0.257029
TOTAL OPERATING COST PER YEAR: |  |  | $12.24 | $4.67
