thecolonel999/Word-Clock/Eagle/Word-Clock.brd

## EAGLE design Eagle/Word-Clock.brd (2015-10-30)

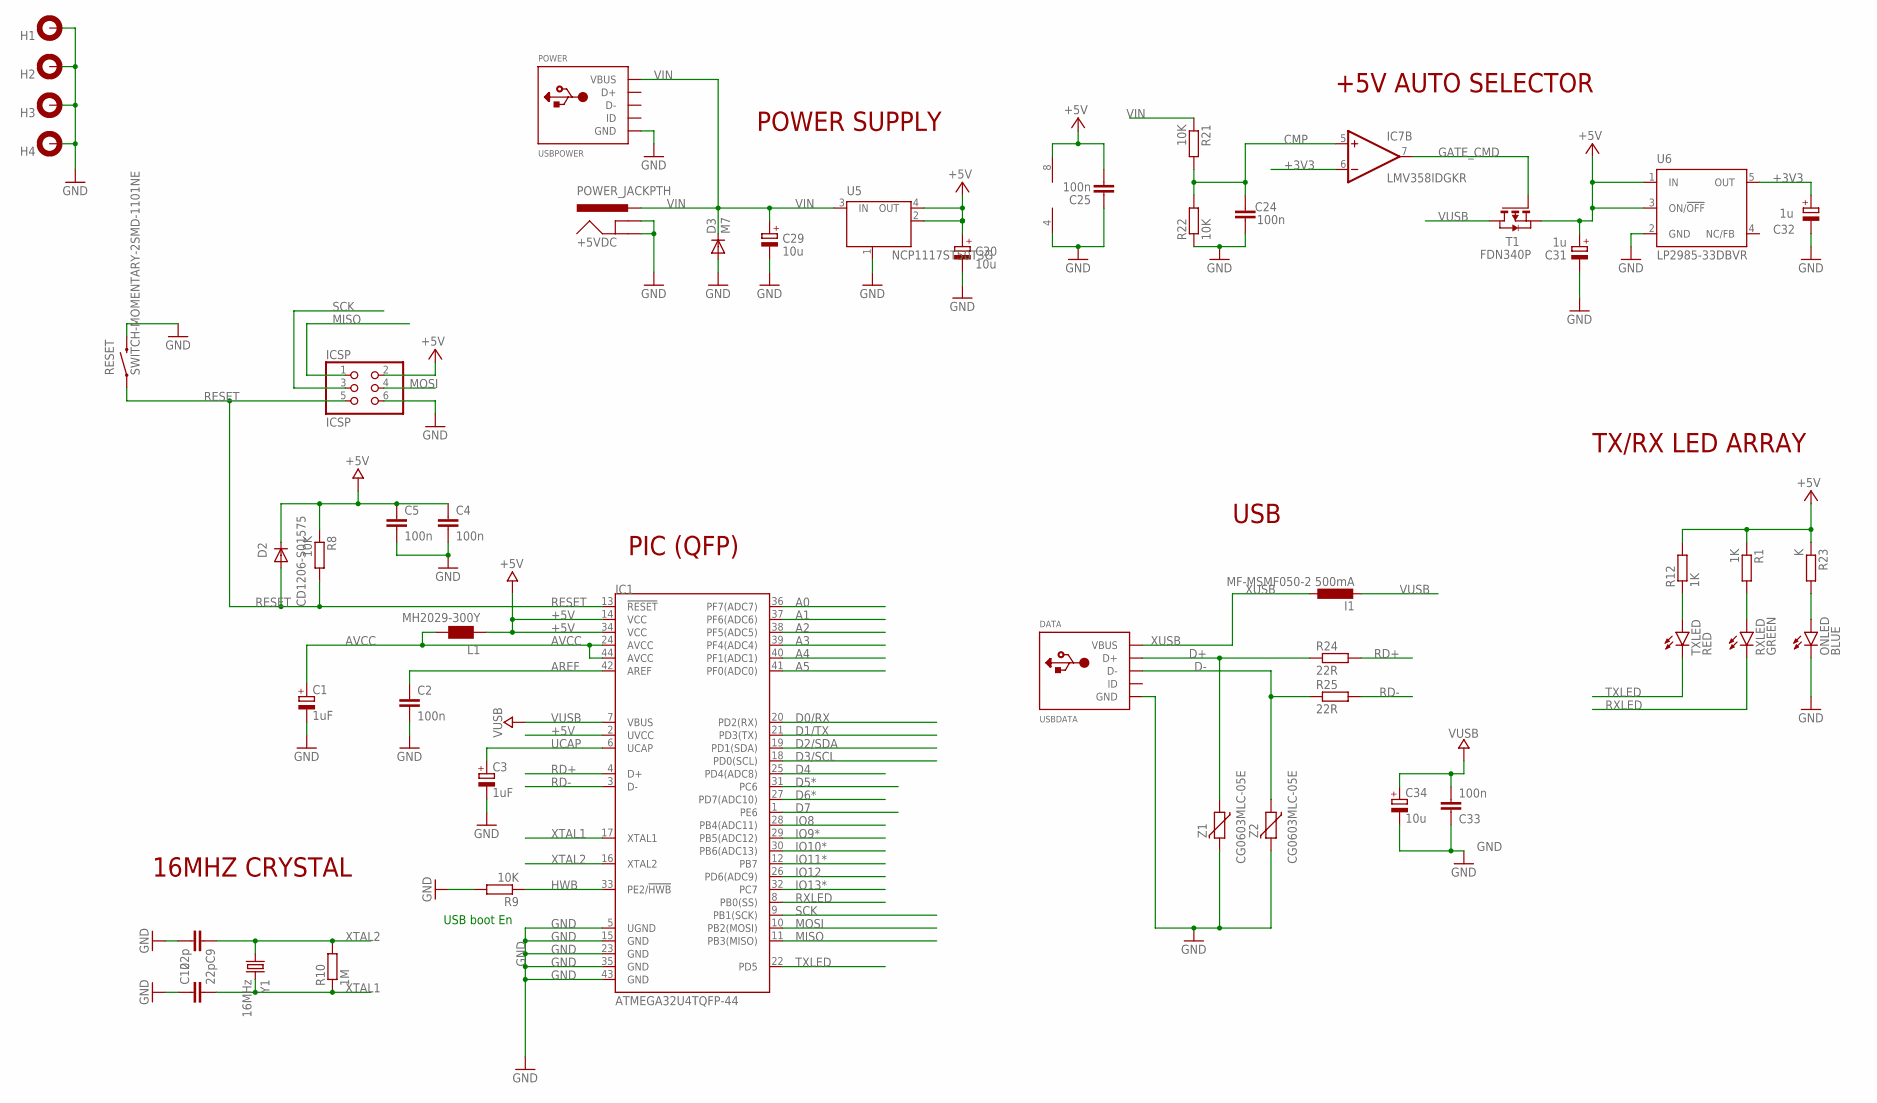
[picture p20: schematic Word-Clock.sch, sheet 1]

Parts:
+5VDC: POWER_JACKPTH; POWER_JACK_PTH
C1, C3: 1uF; B/3528-21W
C2, C4, C5, C24, C25, C33: 100n; C1206
C9, C10: 22p; C1206
C29, C30, C34: 10u; B/3528-21W
C31, C32: 1u; B/3528-21W
D2: CD1206-S01575; MINIMELF
D3: M7; SMB
DATA: USBDATA; USB-MINIB-THM-MOLEX
H1, H2, H3, H4: MOUNT-PAD-ROUND2.8; 2,8-PAD
I1: MF-MSMF050-2 500mA; L1812
IC1: ATMEGA32U4TQFP-44; TQFP44
IC7: LMV358IDGKR; SO08
ICSP: ICSP; 2X03/90
L1: MH2029-300Y; 0805
ONLED: BLUE; LED-1206; FARNELL 2322084
POWER: USBPOWER; USB-MINIB-THM-MOLEX
R1, R12: 1K; R1206
R8, R9, R21, R22: 10K; R1206
R10: 1M; R1206
R23: K; R1206
R24, R25: 22R; R1206
RESET: SWITCH-MOMENTARY-2SMD-1101NE; TACTILE-SWITCH-1101NE
RXLED: GREEN; LED-1206; FARNELL 2322085
T1: FDN340P; SOT-23
TXLED: RED; LED-1206
U5: NCP1117ST50T3G; SOT223; FARNELL 1147874
U6: LP2985-33DBVR; SOT23-DBV
Y1: 16MHz; HC49UP
Z1, Z2: CG0603MLC-05E; CT/CN0603

Connections:
+3V3: C32.+, IC7.6 (-IN), U6.5 (OUT)
+5V: C4.1, C5.1, C25.2, C30.+, C31.+, D2.C, IC1.2 (UVCC), IC1.14 (VCC), IC1.34 (VCC), IC7.8 (V+), ICSP.2, L1.1, R1.1, R8.1, R12.2, R23.1, T1.2 (S), U5.2 (OUT), U5.4 (OUT), U6.1 (IN), U6.3 (ON/!OFF); also elsewhere on the board
A0: IC1.36 (PF7(ADC7)); also elsewhere on the board
A1: IC1.37 (PF6(ADC6)); also elsewhere on the board
A2: IC1.38 (PF5(ADC5)); also elsewhere on the board
A3: IC1.39 (PF4(ADC4)); also elsewhere on the board
A4: IC1.40 (PF1(ADC1)); also elsewhere on the board
A5: IC1.41 (PF0(ADC0)); also elsewhere on the board
AREF: C2.1, IC1.42 (AREF)
AVCC: C1.+, IC1.24 (AVCC), IC1.44 (AVCC), L1.2
CMP: C24.2, IC7.5 (+IN), R21.2, R22.2
D0/RX: IC1.20 (PD2(RX)); also elsewhere on the board
D1/TX: IC1.21 (PD3(TX)); also elsewhere on the board
D2/SDA: IC1.19 (PD1(SDA)); also elsewhere on the board
D3/SCL: IC1.18 (PD0(SCL)); also elsewhere on the board
D4: IC1.25 (PD4(ADC8)); also elsewhere on the board
D5*: IC1.31 (PC6); also elsewhere on the board
D6*: IC1.27 (PD7(ADC10)); also elsewhere on the board
D7: IC1.1 (PE6); also elsewhere on the board
D+: DATA.D+, R24.1, Z1.1
D-: DATA.D-, R25.1, Z2.1
GATE_CMD: IC7.7 (OUT), T1.3 (G)
GND: +5VDC.GND, +5VDC.GNDBREAK, C1.-, C2.2, C3.-, C4.2, C5.2, C9.2, C10.1, C24.1, C25.1, C29.-, C30.-, C31.-, C32.-, C33.1, C34.-, D3.A, DATA.GND, H1.B2,8, H2.B2,8, H3.B2,8, H4.B2,8, IC1.5 (UGND), IC1.15 (GND), IC1.23 (GND), IC1.35 (GND), IC1.43 (GND), IC7.4 (V-), ICSP.6, ONLED.C, POWER.GND, R9.2, R22.1, RESET.2, U5.1 (GND/ADJ), U6.2 (GND), Z1.2, Z2.2; also elsewhere on the board
HWB: IC1.33 (PE2/!HWB), R9.1
IO8: IC1.28 (PB4(ADC11)); also elsewhere on the board
IO9*: IC1.29 (PB5(ADC12)); also elsewhere on the board
IO10*: IC1.30 (PB6(ADC13)); also elsewhere on the board
IO11*: IC1.12 (PB7); also elsewhere on the board
IO12: IC1.26 (PD6(ADC9)); also elsewhere on the board
IO13*: IC1.32 (PC7); also elsewhere on the board
MISO: IC1.11 (PB3(MISO)), ICSP.1
MOSI: IC1.10 (PB2(MOSI)), ICSP.4
unnamed: R12.1, TXLED.A
unnamed: R1.2, RXLED.A
unnamed: ONLED.A, R23.2
RD+: IC1.4 (D+), R24.2
RD-: IC1.3 (D-), R25.2
RESET: D2.A, IC1.13 (!RESET), ICSP.5, R8.2, RESET.1
RXLED: IC1.8 (PB0(SS)), RXLED.C
SCK: IC1.9 (PB1(SCK)), ICSP.3
TXLED: IC1.22 (PD5), TXLED.C
UCAP: C3.+, IC1.6 (UCAP)
VIN: +5VDC.PWR, C29.+, D3.C, POWER.VBUS, R21.1, U5.3 (IN); also elsewhere on the board
VUSB: C33.2, C34.+, I1.2, IC1.7 (VBUS), T1.1 (D)
XTAL1: C10.2, IC1.17 (XTAL1), R10.1, Y1.2
XTAL2: C9.1, IC1.16 (XTAL2), R10.2, Y1.1
XUSB: DATA.VBUS, I1.1

Notes on the sheet:
USB boot En
USB
+5V AUTO SELECTOR
PIC (QFP)
TX/RX LED ARRAY
16MHZ CRYSTAL
POWER SUPPLY

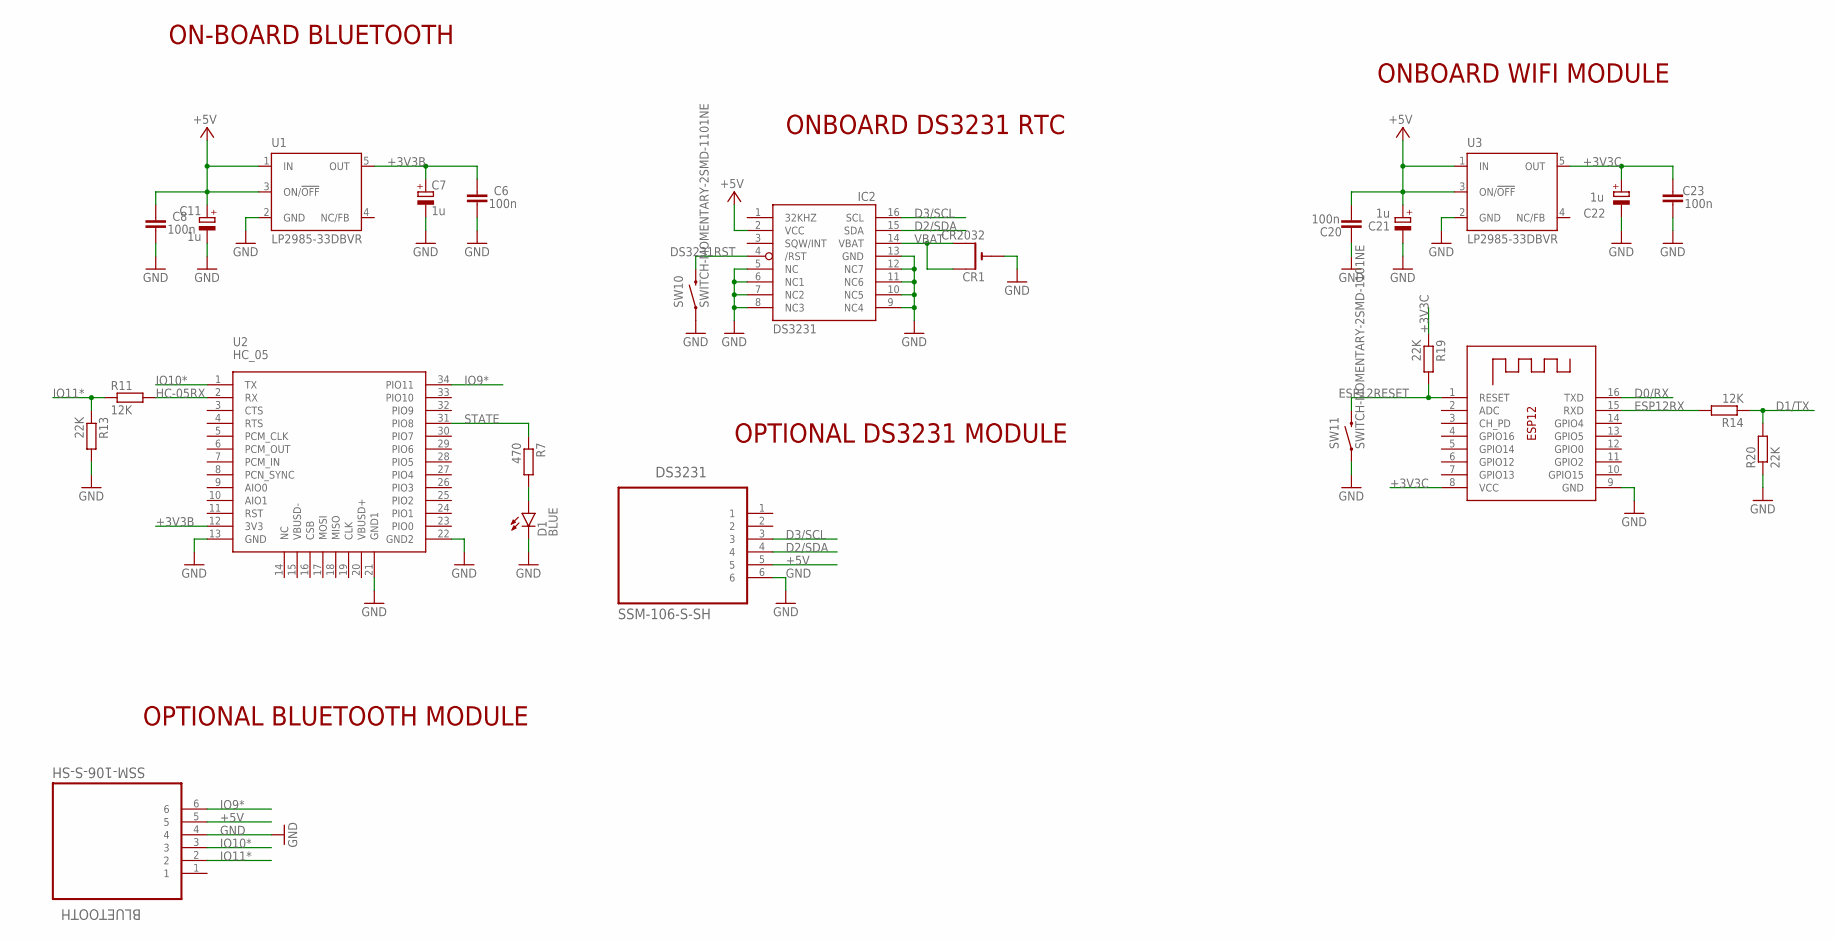
[picture p21: schematic Word-Clock.sch, sheet 2]

Parts:
BLUETOOTH: SSM-106-S-SH; SAMTEC_SSM-106-S-SH
C6, C8, C20, C23: 100n; C1206
C7, C11, C21, C22: 1u; B/3528-21W
CR1: CR2032; CR2032-SMD
D1: BLUE; LED-1206
DS3231: SSM-106-S-SH; SAMTEC_SSM-106-S-SH
ESP12: ESP12; ESP-12
IC2: DS3231/SO; SO16W
R7: 470; R1206
R11, R14: 12K; R1206
R13, R19, R20: 22K; R1206
SW10, SW11: SWITCH-MOMENTARY-2SMD-1101NE; TACTILE-SWITCH-1101NE
U1, U3: LP2985-33DBVR; SOT23-DBV
U2: HC_05; BLUETOOTH_SMD

Connections:
+3V3B: C6.2, C7.+, U1.5 (OUT), U2.12 (3V3)
+3V3C: C22.+, C23.2, ESP12.8 (VCC), R19.1, U3.5 (OUT)
+5V: BLUETOOTH.5, C8.2, C11.+, C20.1, C21.+, DS3231.5, IC2.2 (VCC), U1.1 (IN), U1.3 (ON/!OFF), U3.1 (IN), U3.3 (ON/!OFF); also elsewhere on the board
BLUETOOTHLED: D1.A, R7.2
D0/RX: ESP12.16 (TXD); also elsewhere on the board
D1/TX: R14.1, R20.2; also elsewhere on the board
D2/SDA: DS3231.4, IC2.15 (SDA); also elsewhere on the board
D3/SCL: DS3231.3, IC2.16 (SCL); also elsewhere on the board
DS3231RST: IC2.4 (/RST), SW10.2
ESP12RESET: ESP12.1 (RESET), R19.2, SW11.2
ESP12RX: ESP12.15 (RXD), R14.2
GND: BLUETOOTH.4, C6.1, C7.-, C8.1, C11.-, C20.2, C21.-, C22.-, C23.1, CR1.-, D1.C, DS3231.6, ESP12.9 (GND), IC2.5 (NC), IC2.6 (NC1), IC2.7 (NC2), IC2.8 (NC3), IC2.9 (NC4), IC2.10 (NC5), IC2.11 (NC6), IC2.12 (NC7), IC2.13 (GND), R13.2, R20.1, SW10.1, SW11.1, U1.2 (GND), U2.13 (GND), U2.21 (GND1), U2.22 (GND2), U3.2 (GND); also elsewhere on the board
HC-05RX: R11.2, U2.2 (RX)
IO9*: BLUETOOTH.6, U2.34 (PIO11); also elsewhere on the board
IO10*: BLUETOOTH.3, U2.1 (TX); also elsewhere on the board
IO11*: BLUETOOTH.2, R11.1, R13.1; also elsewhere on the board
STATE: R7.1, U2.31 (PIO8)
VBAT: CR1.+$1 (+), CR1.+$2 (+1), IC2.14 (VBAT)

Notes on the sheet:
ONBOARD DS3231 RTC
OPTIONAL BLUETOOTH MODULE
ON-BOARD BLUETOOTH
OPTIONAL DS3231 MODULE
ONBOARD WIFI MODULE

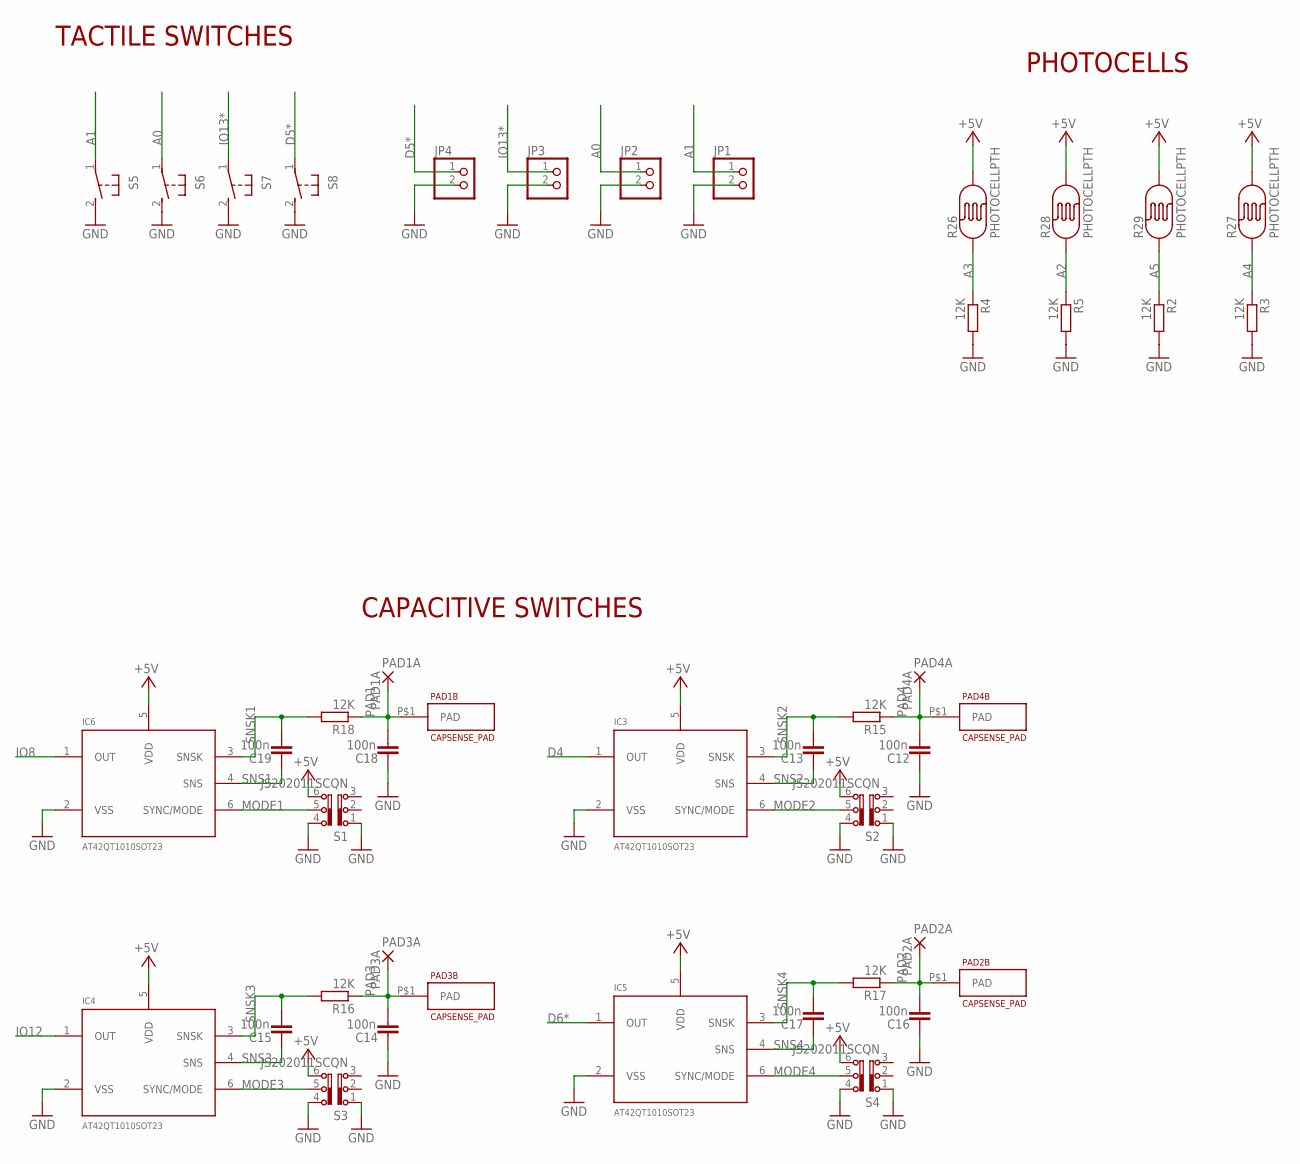
[picture p22: schematic Word-Clock.sch, sheet 3]

Parts:
C12, C13, C14, C15, C16, C17, C18, C19: 100n; C1206
IC3, IC4, IC5, IC6: AT42QT1010SOT23; SOT23-6
JP1, JP2, JP3, JP4: PINHD-1X2/90; 1X02/90
PAD1A: PAD1A; 2,54/1,0
PAD1B, PAD2B, PAD3B, PAD4B: CAPSENSE_PAD
PAD2A: PAD2A; 2,54/1,0
PAD3A: PAD3A; 2,54/1,0
PAD4A: PAD4A; 2,54/1,0
R2, R3, R4, R5, R15, R16, R17, R18: 12K; R1206
R26, R27, R28, R29: PHOTOCELLPTH; PHOTOCELL
S1, S2, S3, S4: JS202011SCQN
S5, S6, S7, S8: 31-XX; B3F-31XX

Connections:
+5V: IC3.5 (VDD), IC4.5 (VDD), IC5.5 (VDD), IC6.5 (VDD), R26.2, R27.2, R28.2, R29.2, S1.6, S2.6, S3.6, S4.6; also elsewhere on the board
A0: JP2.1, S6.1; also elsewhere on the board
A1: JP1.1, S5.1; also elsewhere on the board
A2: R5.1, R28.1; also elsewhere on the board
A3: R4.1, R26.1; also elsewhere on the board
A4: R3.1, R27.1; also elsewhere on the board
A5: R2.1, R29.1; also elsewhere on the board
D4: IC3.1 (OUT); also elsewhere on the board
D5*: JP4.1, S8.1; also elsewhere on the board
D6*: IC5.1 (OUT); also elsewhere on the board
GND: C12.2, C14.2, C16.2, C18.2, IC3.2 (VSS), IC4.2 (VSS), IC5.2 (VSS), IC6.2 (VSS), JP1.2, JP2.2, JP3.2, JP4.2, R2.2, R3.2, R4.2, R5.2, S1.1, S1.4, S2.1, S2.4, S3.1, S3.4, S4.1, S4.4, S5.2 (S), S6.2 (S), S7.2 (S), S8.2 (S); also elsewhere on the board
IO8: IC6.1 (OUT); also elsewhere on the board
IO12: IC4.1 (OUT); also elsewhere on the board
IO13*: JP3.1, S7.1; also elsewhere on the board
MODE1: IC6.6 (SYNC/MODE), S1.5
MODE2: IC3.6 (SYNC/MODE), S2.5
MODE3: IC4.6 (SYNC/MODE), S3.5
MODE4: IC5.6 (SYNC/MODE), S4.5
PAD1: C18.1, PAD1A.1, PAD1B.P$1, R18.1
PAD2: C16.1, PAD2A.1, PAD2B.P$1, R17.1
PAD3: C14.1, PAD3A.1, PAD3B.P$1, R16.1
PAD4: C12.1, PAD4A.1, PAD4B.P$1, R15.1
SNS1: C19.2, IC6.4 (SNS)
SNS2: C13.2, IC3.4 (SNS)
SNS3: C15.2, IC4.4 (SNS)
SNS4: C17.2, IC5.4 (SNS)
SNSK1: C19.1, IC6.3 (SNSK), R18.2
SNSK2: C13.1, IC3.3 (SNSK), R15.2
SNSK3: C15.1, IC4.3 (SNSK), R16.2
SNSK4: C17.1, IC5.3 (SNSK), R17.2

Notes on the sheet:
CAPACITIVE SWITCHES
TACTILE SWITCHES
PHOTOCELLS
