thecolonel999/Word-Clock/Eagle/Word-Clock.brd

## EAGLE design Eagle/Word-Clock.brd (continued)

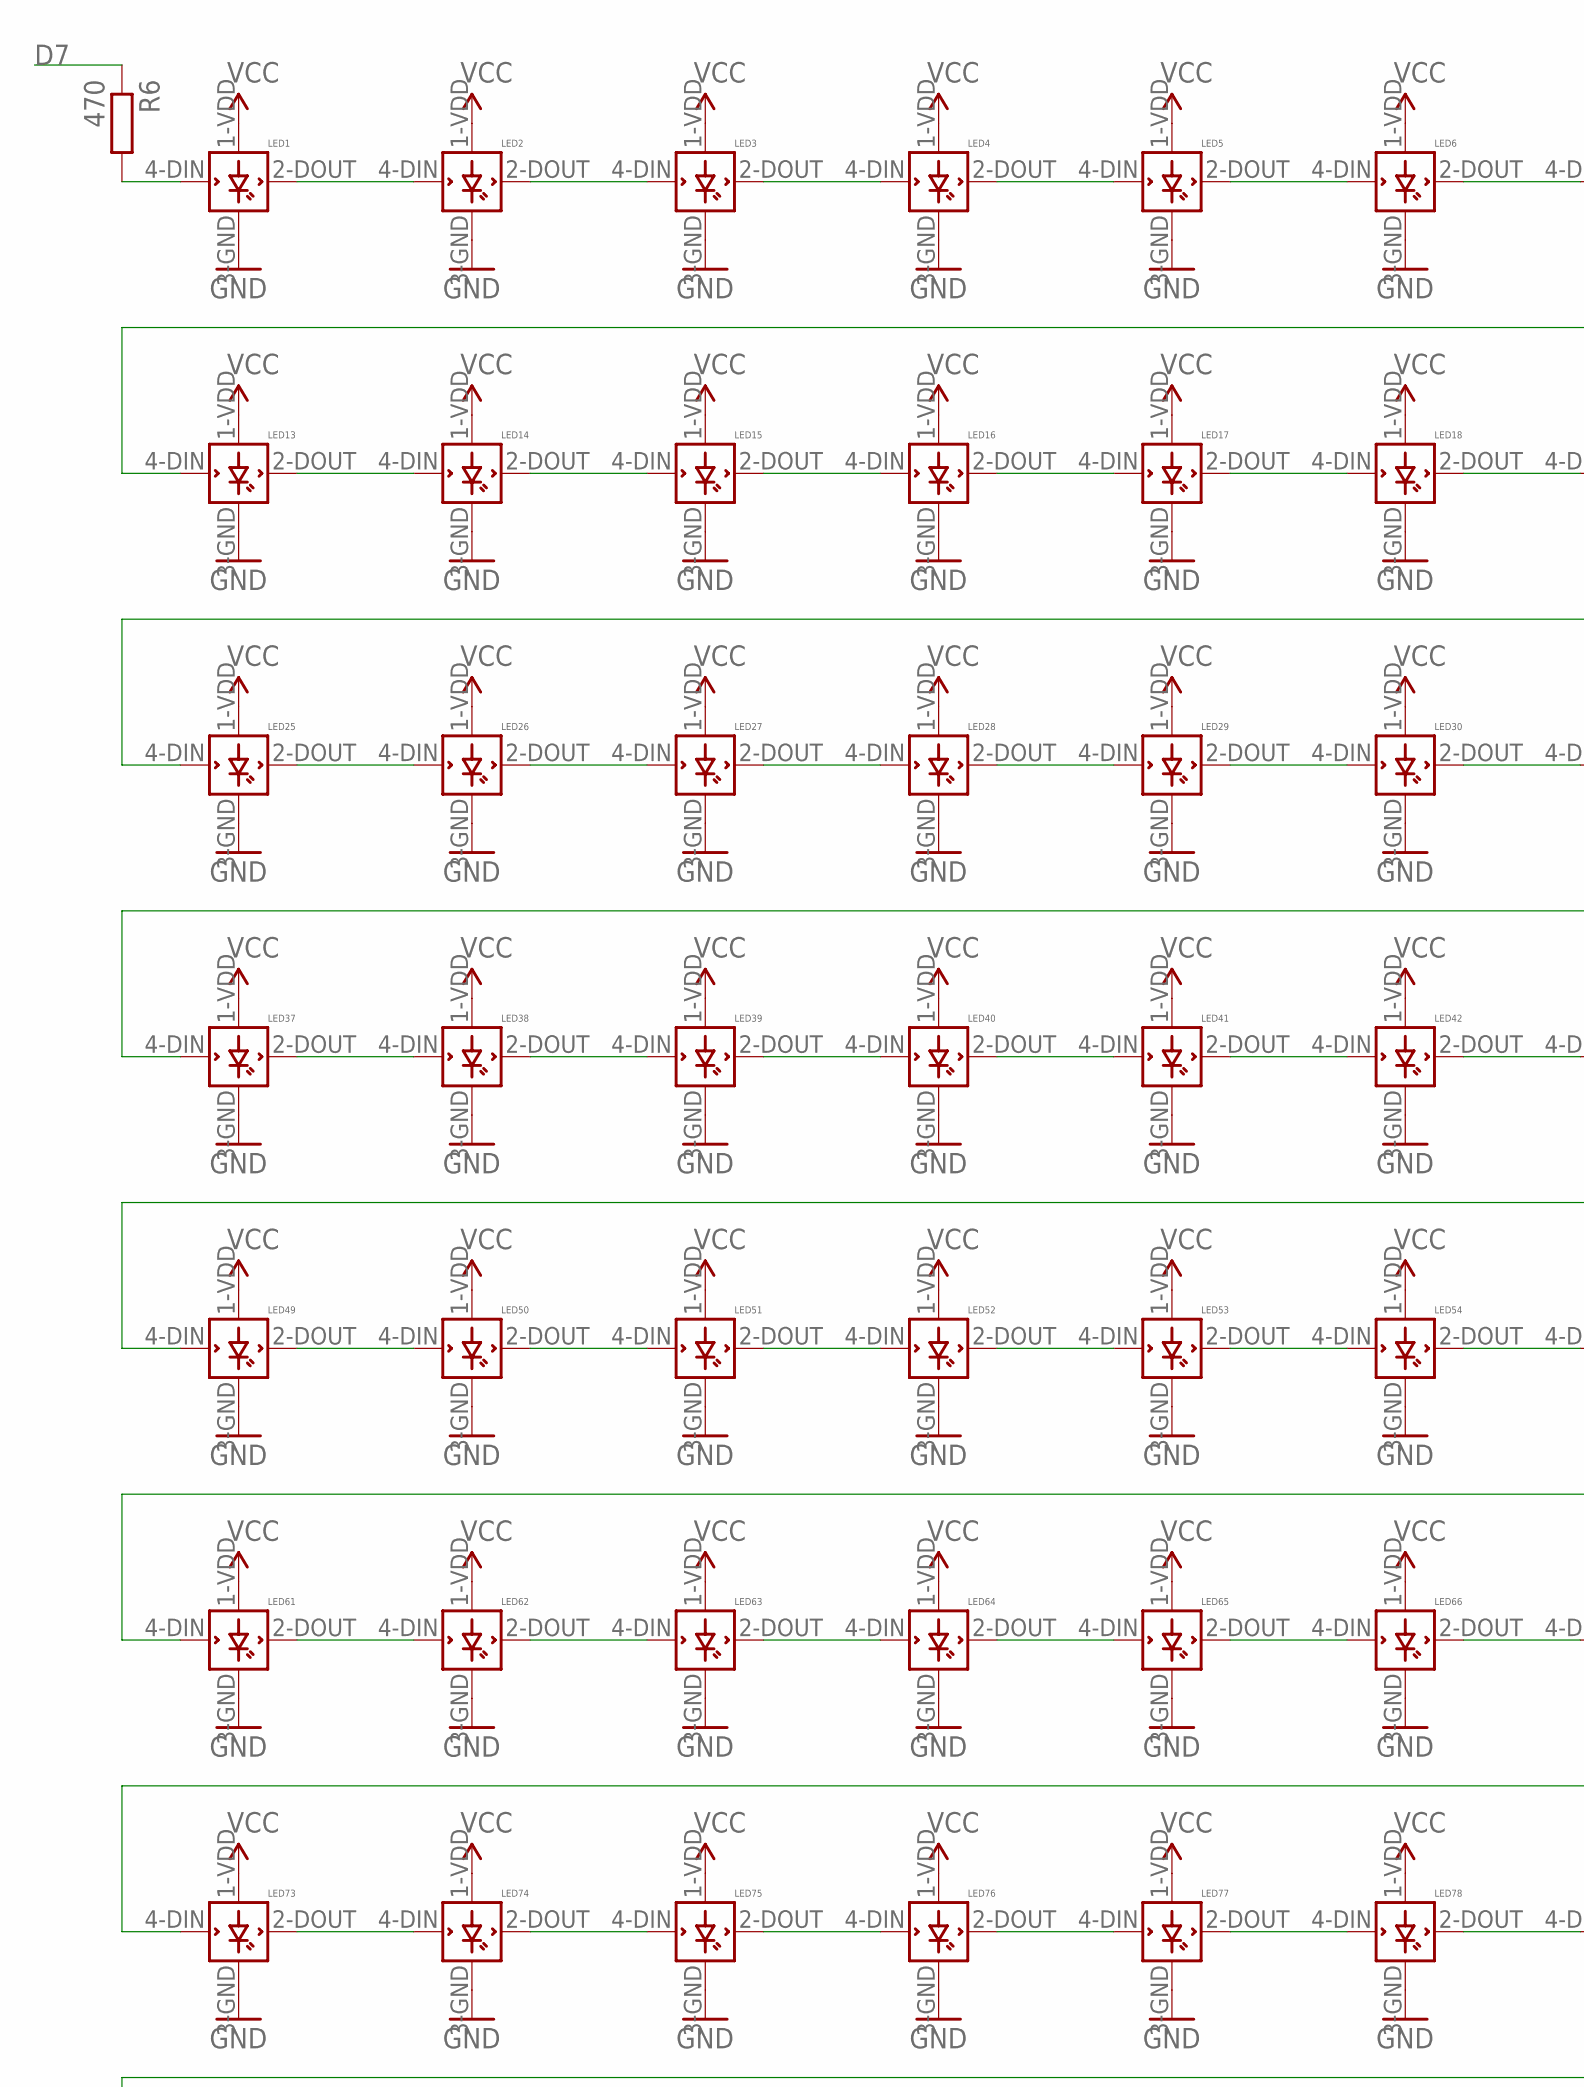
[picture p23: schematic Word-Clock.sch, sheet 4, part in row 1, column 1]

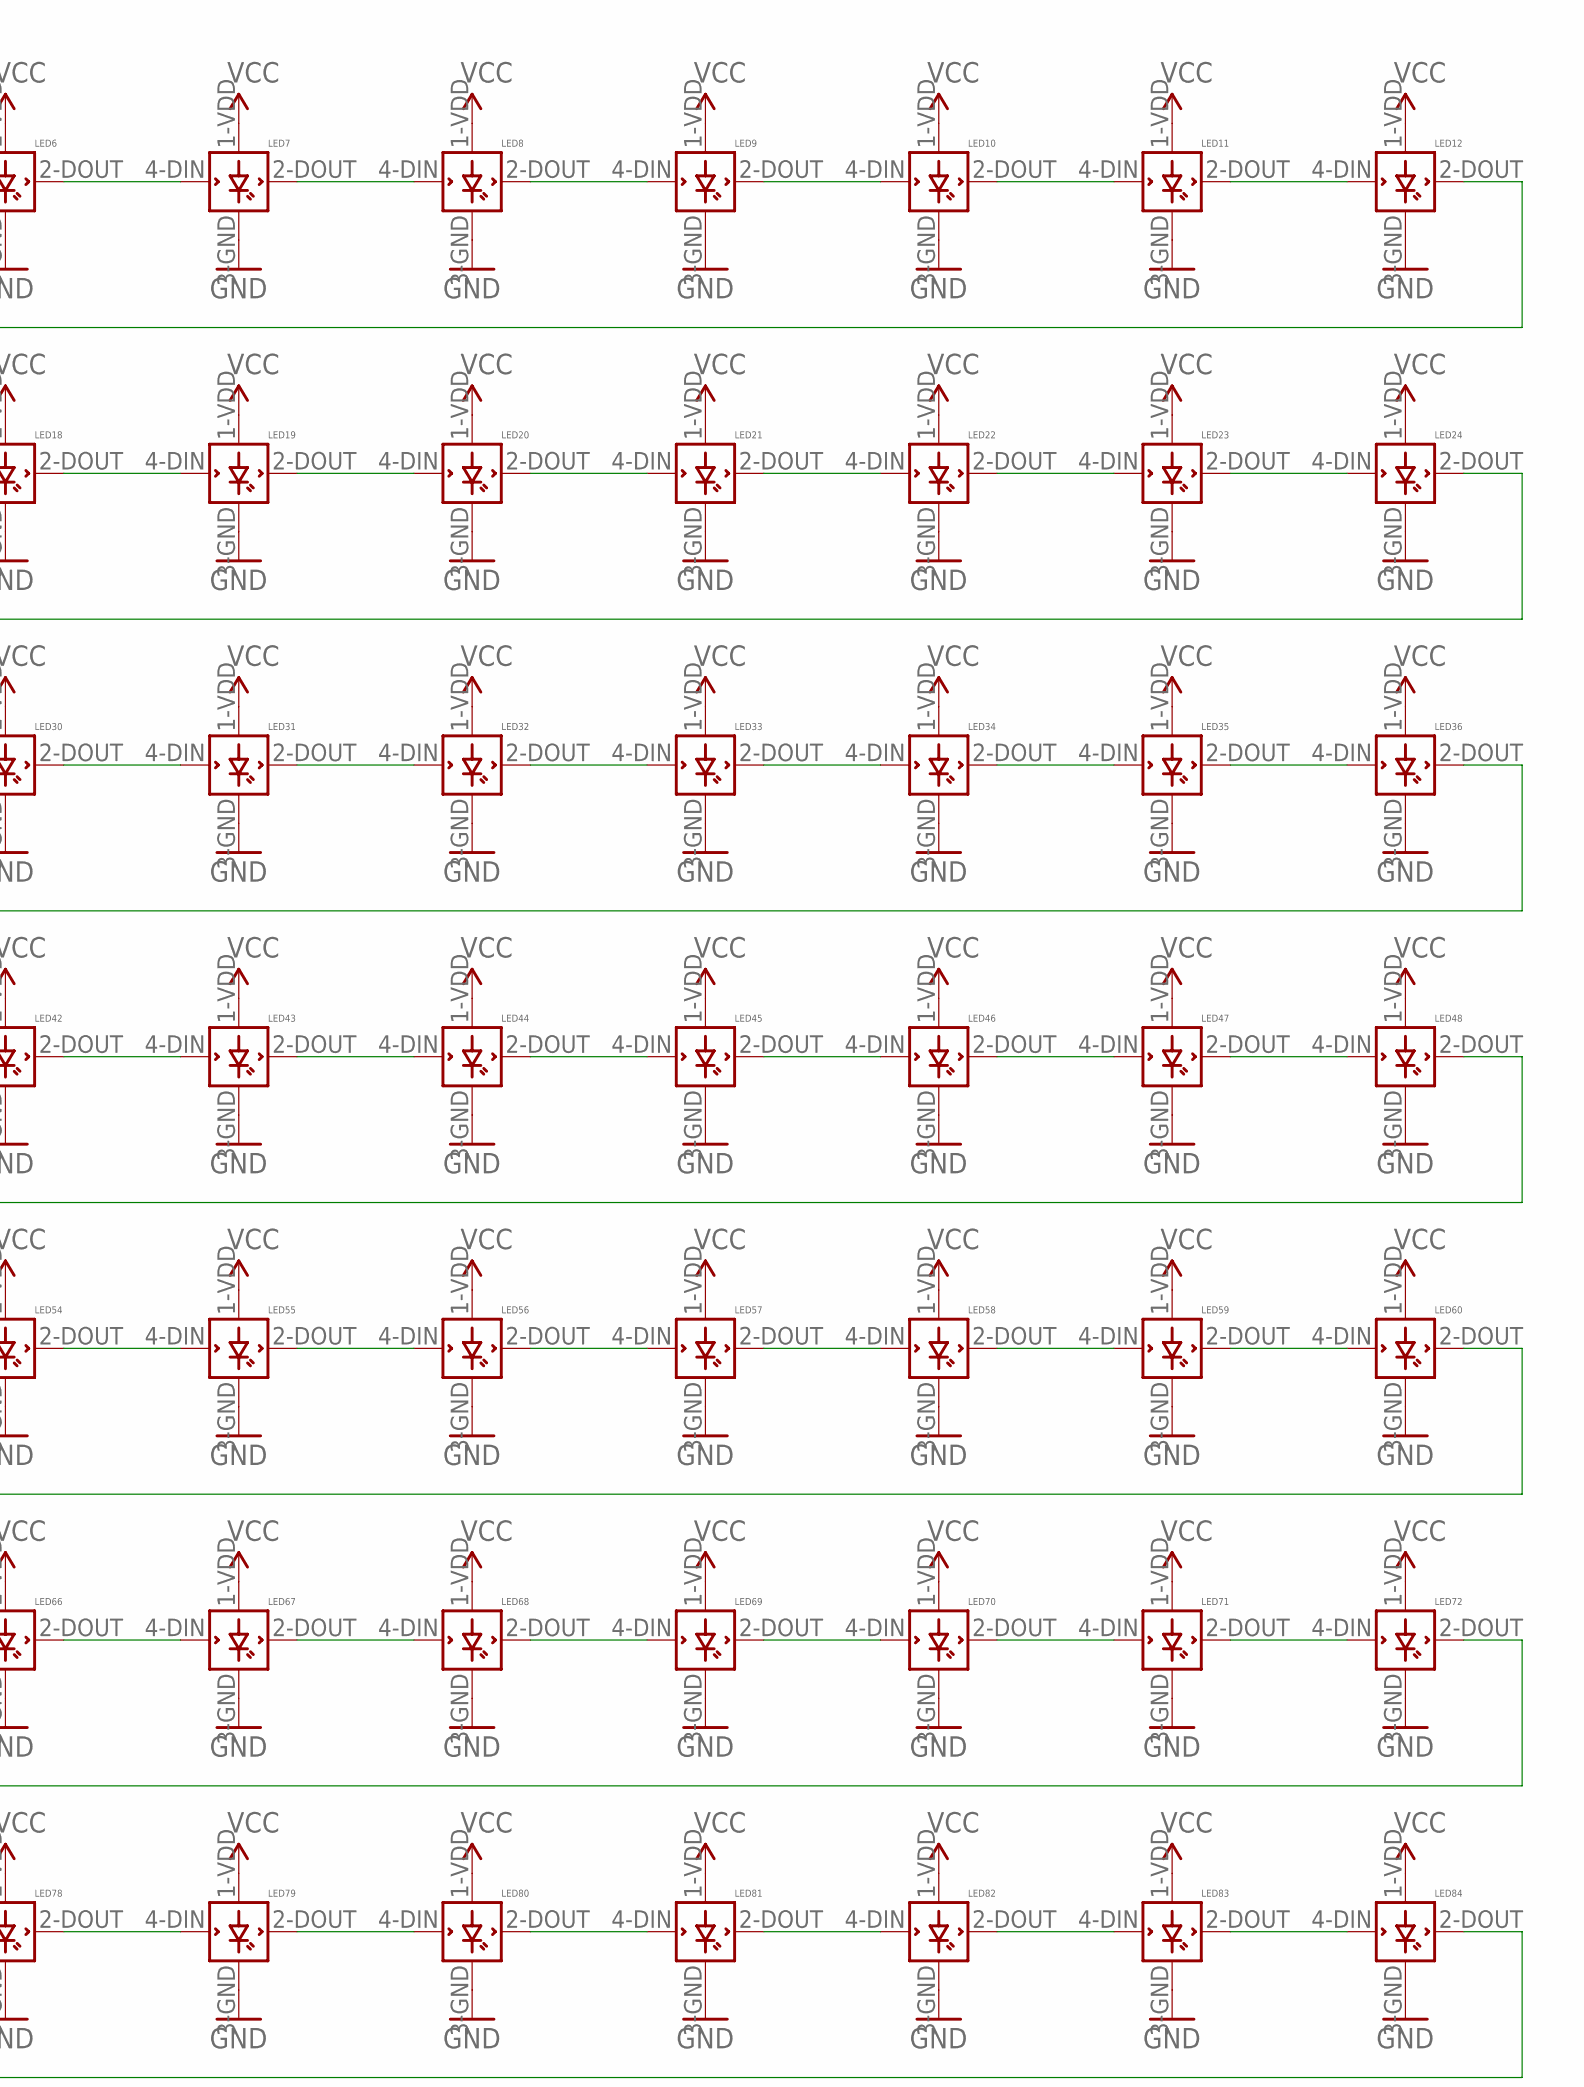
[picture p24: schematic Word-Clock.sch, sheet 4, part in row 1, column 2]

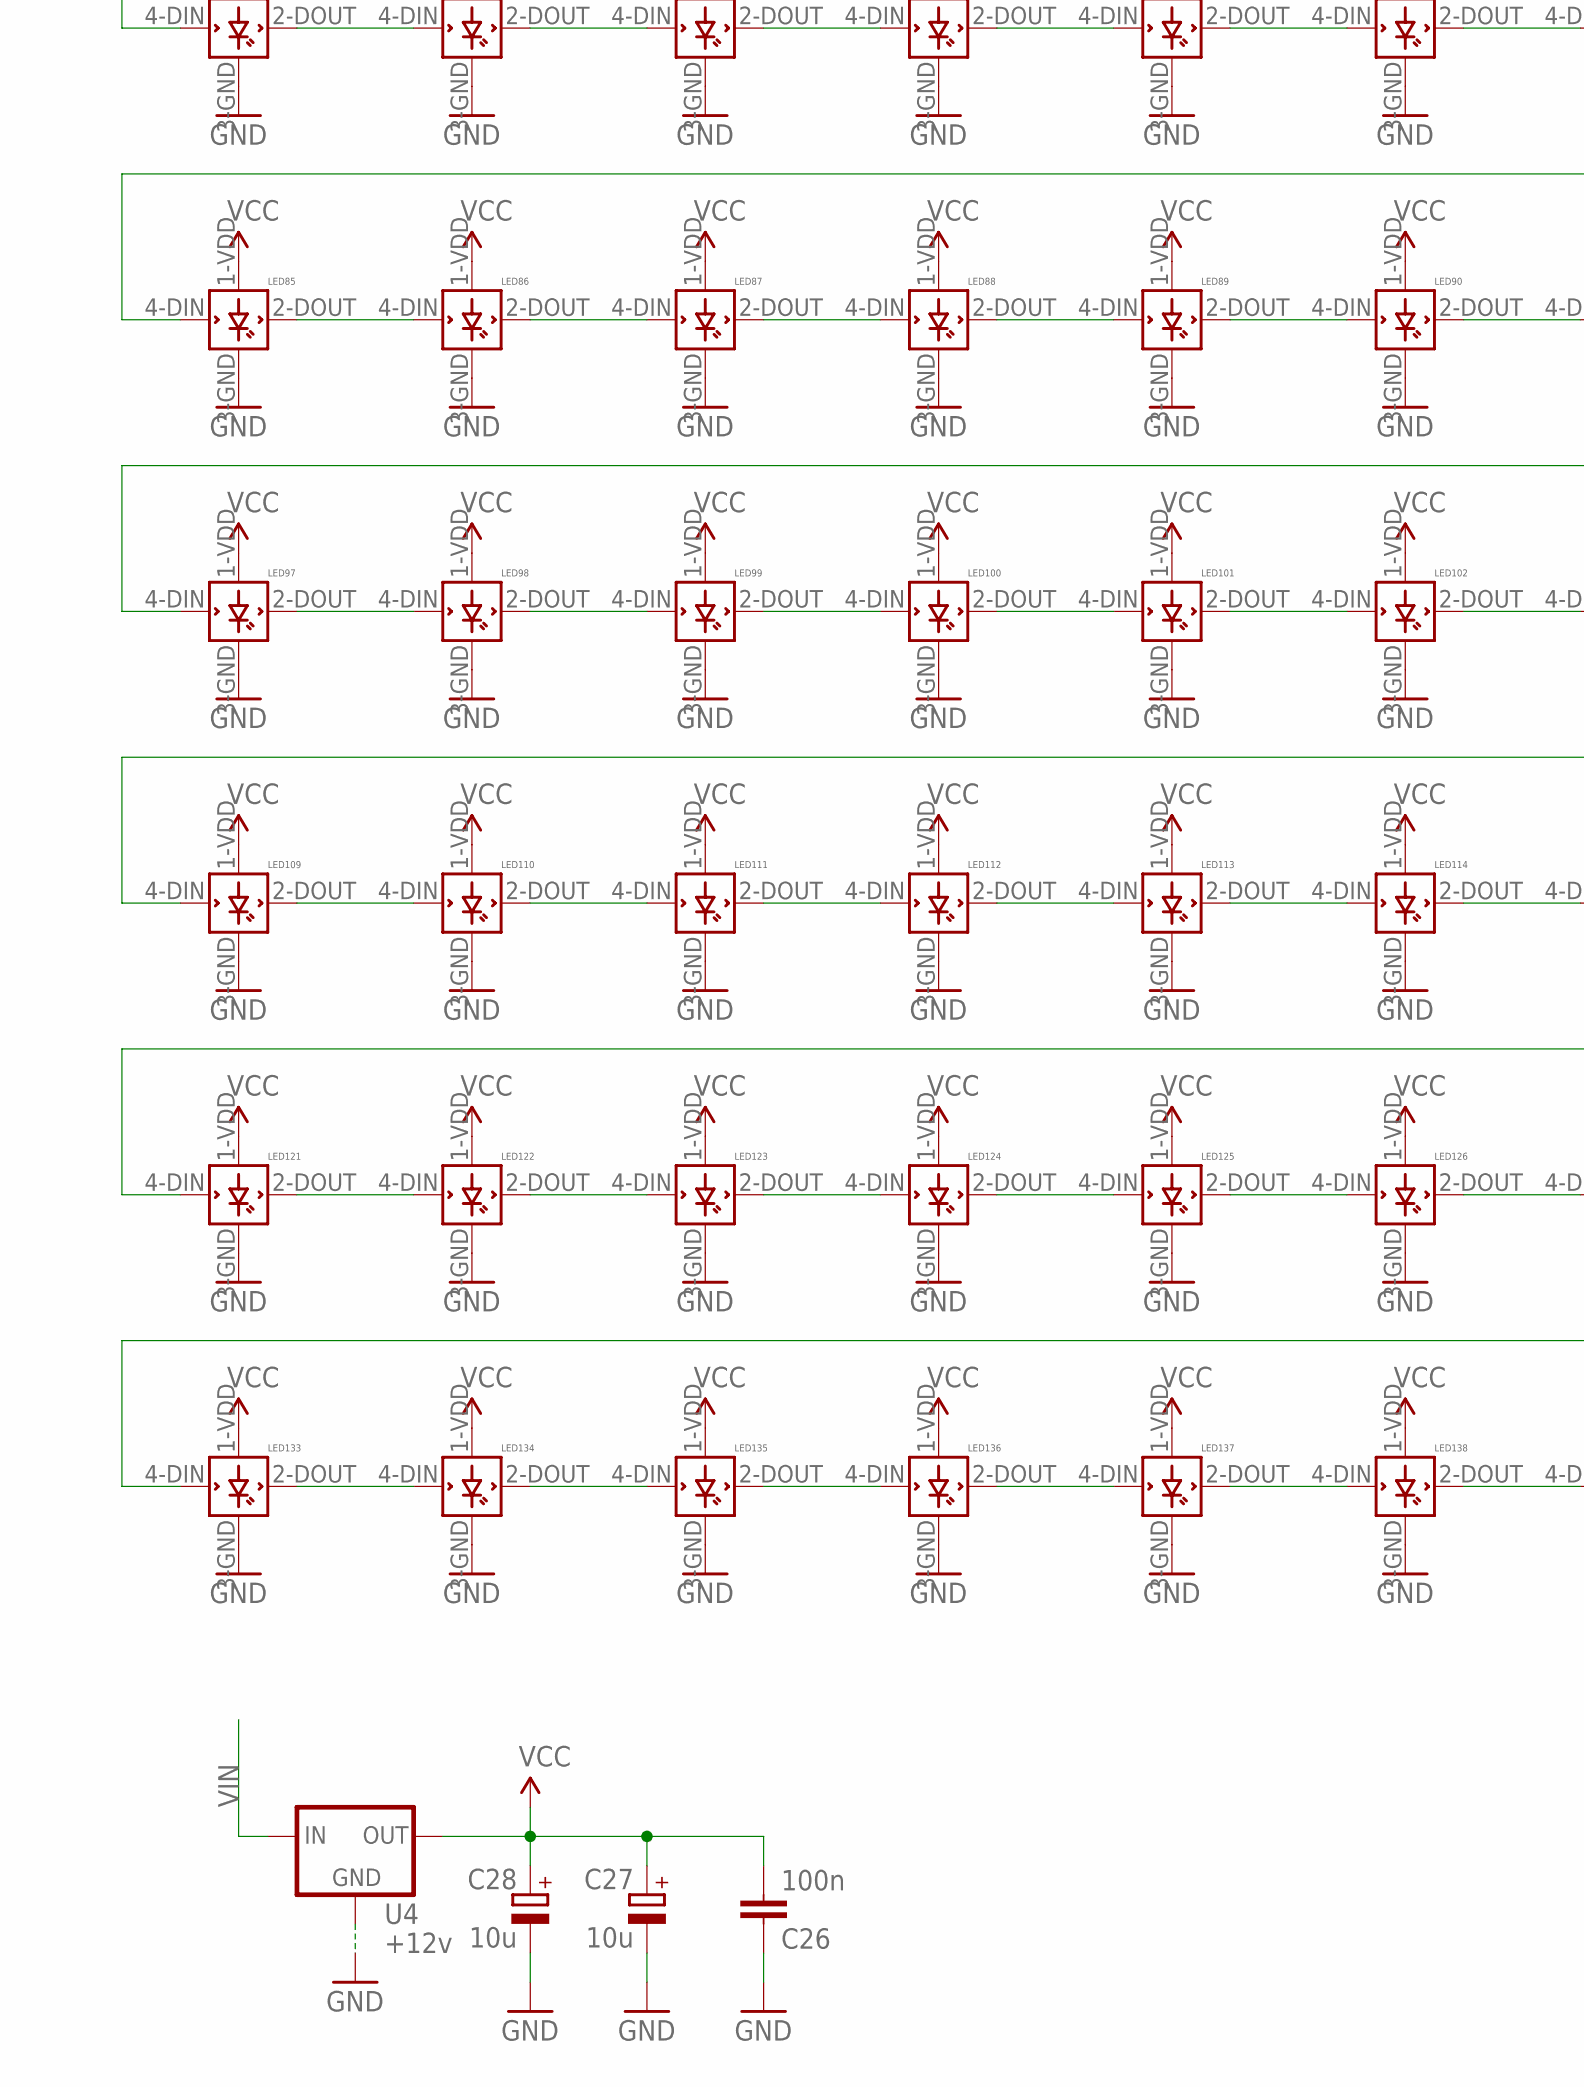
[picture p25: schematic Word-Clock.sch, sheet 4, part in row 2, column 1]

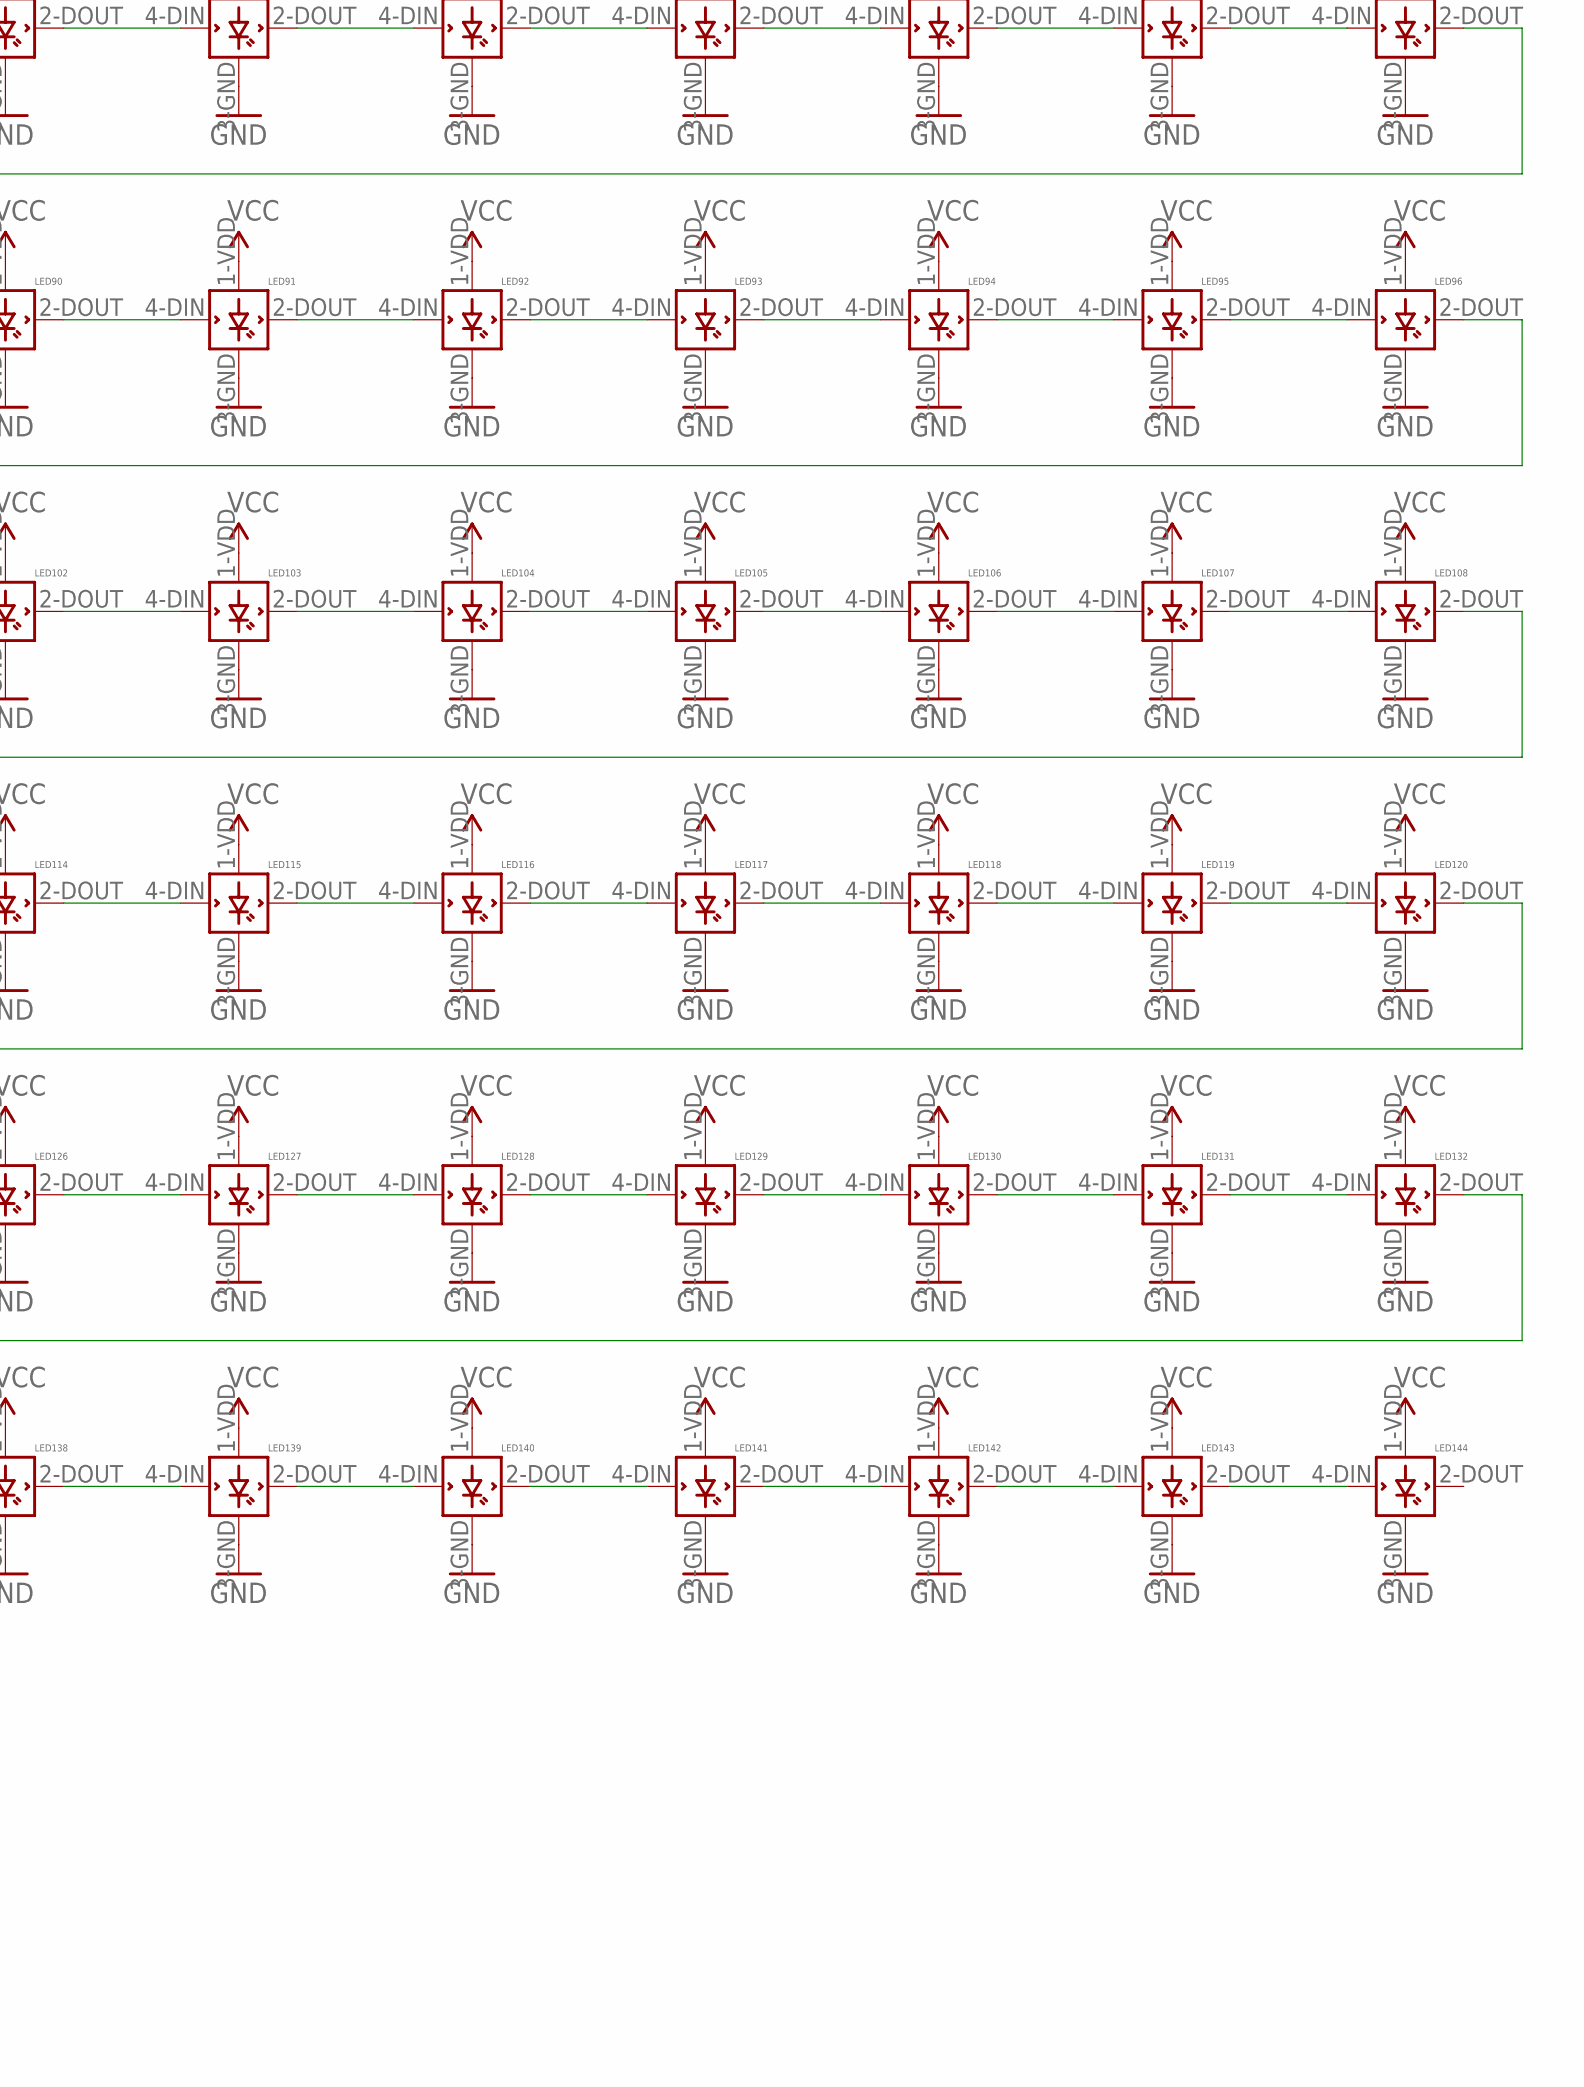
[picture p26: schematic Word-Clock.sch, sheet 4, part in row 2, column 2]

Parts:
C26: 100n; C1206
C27, C28: 10u; B/3528-21W
LED1, LED2, LED3, LED4, LED5, LED6, LED7, LED8, LED9, LED10, LED11, LED12, LED13, LED14, LED15, LED16, LED17, LED18, LED19, LED20, LED21, LED22, LED23, LED24, LED25, LED26, LED27, LED28, LED29, LED30, LED31, LED32, LED33, LED34, LED35, LED36, LED37, LED38, LED39, LED40, LED41, LED42, LED43, LED44, LED45, LED46, LED47, LED48, LED49, LED50, LED51, LED52, LED53, LED54, LED55, LED56, LED57, LED58, LED59, LED60, LED61, LED62, LED63, LED64, LED65, LED66, LED67, LED68, LED69, LED70, LED71, LED72, LED73, LED74, LED75, LED76, LED77, LED78, LED79, LED80, LED81, LED82, LED83, LED84, LED85, LED86, LED87, LED88, LED89, LED90, LED91, LED92, LED93, LED94, LED95, LED96, LED97, LED98, LED99, LED100, LED101, LED102, LED103, LED104, LED105, LED106, LED107, LED108, LED109, LED110, LED111, LED112, LED113, LED114, LED115, LED116, LED117, LED118, LED119, LED120, LED121, LED122, LED123, LED124, LED125, LED126, LED127, LED128, LED129, LED130, LED131, LED132, LED133, LED134, LED135, LED136, LED137, LED138, LED139, LED140, LED141, LED142, LED143, LED144: WS2812B
R6: 470; R1206
U4: +12v; TO-252

Connections:
D7: R6.1; also elsewhere on the board
GND: C26.1, C27.-, C28.-, LED1.3-GND (GND), LED2.3-GND (GND), LED3.3-GND (GND), LED4.3-GND (GND), LED5.3-GND (GND), LED6.3-GND (GND), LED7.3-GND (GND), LED8.3-GND (GND), LED9.3-GND (GND), LED10.3-GND (GND), LED11.3-GND (GND), LED12.3-GND (GND), LED13.3-GND (GND), LED14.3-GND (GND), LED15.3-GND (GND), LED16.3-GND (GND), LED17.3-GND (GND), LED18.3-GND (GND), LED19.3-GND (GND), LED20.3-GND (GND), LED21.3-GND (GND), LED22.3-GND (GND), LED23.3-GND (GND), LED24.3-GND (GND), LED25.3-GND (GND), LED26.3-GND (GND), LED27.3-GND (GND), LED28.3-GND (GND), LED29.3-GND (GND), LED30.3-GND (GND), LED31.3-GND (GND), LED32.3-GND (GND), LED33.3-GND (GND), LED34.3-GND (GND), LED35.3-GND (GND), LED36.3-GND (GND), LED37.3-GND (GND), LED38.3-GND (GND), LED39.3-GND (GND), LED40.3-GND (GND), LED41.3-GND (GND), LED42.3-GND (GND), LED43.3-GND (GND), LED44.3-GND (GND), LED45.3-GND (GND), LED46.3-GND (GND), LED47.3-GND (GND), LED48.3-GND (GND), LED49.3-GND (GND), LED50.3-GND (GND), LED51.3-GND (GND), LED52.3-GND (GND), LED53.3-GND (GND), LED54.3-GND (GND), LED55.3-GND (GND), LED56.3-GND (GND), LED57.3-GND (GND), LED58.3-GND (GND), LED59.3-GND (GND), LED60.3-GND (GND), LED61.3-GND (GND), LED62.3-GND (GND), LED63.3-GND (GND), LED64.3-GND (GND), LED65.3-GND (GND), LED66.3-GND (GND), LED67.3-GND (GND), LED68.3-GND (GND), LED69.3-GND (GND), LED70.3-GND (GND), LED71.3-GND (GND), LED72.3-GND (GND), LED73.3-GND (GND), LED74.3-GND (GND), LED75.3-GND (GND), LED76.3-GND (GND), LED77.3-GND (GND), LED78.3-GND (GND), LED79.3-GND (GND), LED80.3-GND (GND), LED81.3-GND (GND), LED82.3-GND (GND), LED83.3-GND (GND), LED84.3-GND (GND), LED85.3-GND (GND), LED86.3-GND (GND), LED87.3-GND (GND), LED88.3-GND (GND), LED89.3-GND (GND), LED90.3-GND (GND), LED91.3-GND (GND), LED92.3-GND (GND), LED93.3-GND (GND), LED94.3-GND (GND), LED95.3-GND (GND), LED96.3-GND (GND), LED97.3-GND (GND), LED98.3-GND (GND), LED99.3-GND (GND), LED100.3-GND (GND), LED101.3-GND (GND), LED102.3-GND (GND), LED103.3-GND (GND), LED104.3-GND (GND), LED105.3-GND (GND), LED106.3-GND (GND), LED107.3-GND (GND), LED108.3-GND (GND), LED109.3-GND (GND), LED110.3-GND (GND), LED111.3-GND (GND), LED112.3-GND (GND), LED113.3-GND (GND), LED114.3-GND (GND), LED115.3-GND (GND), LED116.3-GND (GND), LED117.3-GND (GND), LED118.3-GND (GND), LED119.3-GND (GND), LED120.3-GND (GND), LED121.3-GND (GND), LED122.3-GND (GND), LED123.3-GND (GND), LED124.3-GND (GND), LED125.3-GND (GND), LED126.3-GND (GND), LED127.3-GND (GND), LED128.3-GND (GND), LED129.3-GND (GND), LED130.3-GND (GND), LED131.3-GND (GND), LED132.3-GND (GND), LED133.3-GND (GND), LED134.3-GND (GND), LED135.3-GND (GND), LED136.3-GND (GND), LED137.3-GND (GND), LED138.3-GND (GND), LED139.3-GND (GND), LED140.3-GND (GND), LED141.3-GND (GND), LED142.3-GND (GND), LED143.3-GND (GND), LED144.3-GND (GND), U4.3 (GND); also elsewhere on the board
unnamed: LED1.2-DOUT (DOUT), LED2.4-DIN (DIN)
unnamed: LED2.2-DOUT (DOUT), LED3.4-DIN (DIN)
unnamed: LED3.2-DOUT (DOUT), LED4.4-DIN (DIN)
unnamed: LED4.2-DOUT (DOUT), LED5.4-DIN (DIN)
unnamed: LED5.2-DOUT (DOUT), LED6.4-DIN (DIN)
unnamed: LED6.2-DOUT (DOUT), LED7.4-DIN (DIN)
unnamed: LED7.2-DOUT (DOUT), LED8.4-DIN (DIN)
unnamed: LED8.2-DOUT (DOUT), LED9.4-DIN (DIN)
unnamed: LED9.2-DOUT (DOUT), LED10.4-DIN (DIN)
unnamed: LED10.2-DOUT (DOUT), LED11.4-DIN (DIN)
unnamed: LED11.2-DOUT (DOUT), LED12.4-DIN (DIN)
unnamed: LED13.2-DOUT (DOUT), LED14.4-DIN (DIN)
unnamed: LED14.2-DOUT (DOUT), LED15.4-DIN (DIN)
unnamed: LED15.2-DOUT (DOUT), LED16.4-DIN (DIN)
unnamed: LED16.2-DOUT (DOUT), LED17.4-DIN (DIN)
unnamed: LED17.2-DOUT (DOUT), LED18.4-DIN (DIN)
unnamed: LED18.2-DOUT (DOUT), LED19.4-DIN (DIN)
unnamed: LED19.2-DOUT (DOUT), LED20.4-DIN (DIN)
unnamed: LED20.2-DOUT (DOUT), LED21.4-DIN (DIN)
unnamed: LED21.2-DOUT (DOUT), LED22.4-DIN (DIN)
unnamed: LED22.2-DOUT (DOUT), LED23.4-DIN (DIN)
unnamed: LED23.2-DOUT (DOUT), LED24.4-DIN (DIN)
unnamed: LED25.2-DOUT (DOUT), LED26.4-DIN (DIN)
unnamed: LED26.2-DOUT (DOUT), LED27.4-DIN (DIN)
unnamed: LED27.2-DOUT (DOUT), LED28.4-DIN (DIN)
unnamed: LED28.2-DOUT (DOUT), LED29.4-DIN (DIN)
unnamed: LED29.2-DOUT (DOUT), LED30.4-DIN (DIN)
unnamed: LED30.2-DOUT (DOUT), LED31.4-DIN (DIN)
unnamed: LED31.2-DOUT (DOUT), LED32.4-DIN (DIN)
unnamed: LED32.2-DOUT (DOUT), LED33.4-DIN (DIN)
unnamed: LED33.2-DOUT (DOUT), LED34.4-DIN (DIN)
unnamed: LED34.2-DOUT (DOUT), LED35.4-DIN (DIN)
unnamed: LED35.2-DOUT (DOUT), LED36.4-DIN (DIN)
unnamed: LED37.2-DOUT (DOUT), LED38.4-DIN (DIN)
unnamed: LED38.2-DOUT (DOUT), LED39.4-DIN (DIN)
unnamed: LED39.2-DOUT (DOUT), LED40.4-DIN (DIN)
unnamed: LED40.2-DOUT (DOUT), LED41.4-DIN (DIN)
unnamed: LED41.2-DOUT (DOUT), LED42.4-DIN (DIN)
unnamed: LED42.2-DOUT (DOUT), LED43.4-DIN (DIN)
unnamed: LED43.2-DOUT (DOUT), LED44.4-DIN (DIN)
unnamed: LED44.2-DOUT (DOUT), LED45.4-DIN (DIN)
unnamed: LED45.2-DOUT (DOUT), LED46.4-DIN (DIN)
unnamed: LED46.2-DOUT (DOUT), LED47.4-DIN (DIN)
unnamed: LED47.2-DOUT (DOUT), LED48.4-DIN (DIN)
unnamed: LED49.2-DOUT (DOUT), LED50.4-DIN (DIN)
unnamed: LED50.2-DOUT (DOUT), LED51.4-DIN (DIN)
unnamed: LED51.2-DOUT (DOUT), LED52.4-DIN (DIN)
unnamed: LED52.2-DOUT (DOUT), LED53.4-DIN (DIN)
unnamed: LED53.2-DOUT (DOUT), LED54.4-DIN (DIN)
unnamed: LED54.2-DOUT (DOUT), LED55.4-DIN (DIN)
unnamed: LED55.2-DOUT (DOUT), LED56.4-DIN (DIN)
unnamed: LED56.2-DOUT (DOUT), LED57.4-DIN (DIN)
unnamed: LED57.2-DOUT (DOUT), LED58.4-DIN (DIN)
unnamed: LED58.2-DOUT (DOUT), LED59.4-DIN (DIN)
unnamed: LED59.2-DOUT (DOUT), LED60.4-DIN (DIN)
unnamed: LED61.2-DOUT (DOUT), LED62.4-DIN (DIN)
unnamed: LED62.2-DOUT (DOUT), LED63.4-DIN (DIN)
unnamed: LED63.2-DOUT (DOUT), LED64.4-DIN (DIN)
unnamed: LED64.2-DOUT (DOUT), LED65.4-DIN (DIN)
unnamed: LED65.2-DOUT (DOUT), LED66.4-DIN (DIN)
unnamed: LED66.2-DOUT (DOUT), LED67.4-DIN (DIN)
unnamed: LED67.2-DOUT (DOUT), LED68.4-DIN (DIN)
unnamed: LED68.2-DOUT (DOUT), LED69.4-DIN (DIN)
unnamed: LED69.2-DOUT (DOUT), LED70.4-DIN (DIN)
unnamed: LED70.2-DOUT (DOUT), LED71.4-DIN (DIN)
unnamed: LED71.2-DOUT (DOUT), LED72.4-DIN (DIN)
unnamed: LED73.2-DOUT (DOUT), LED74.4-DIN (DIN)
unnamed: LED74.2-DOUT (DOUT), LED75.4-DIN (DIN)
unnamed: LED75.2-DOUT (DOUT), LED76.4-DIN (DIN)
unnamed: LED76.2-DOUT (DOUT), LED77.4-DIN (DIN)
unnamed: LED77.2-DOUT (DOUT), LED78.4-DIN (DIN)
unnamed: LED78.2-DOUT (DOUT), LED79.4-DIN (DIN)
unnamed: LED79.2-DOUT (DOUT), LED80.4-DIN (DIN)
unnamed: LED80.2-DOUT (DOUT), LED81.4-DIN (DIN)
unnamed: LED81.2-DOUT (DOUT), LED82.4-DIN (DIN)
unnamed: LED82.2-DOUT (DOUT), LED83.4-DIN (DIN)
unnamed: LED83.2-DOUT (DOUT), LED84.4-DIN (DIN)
unnamed: LED85.2-DOUT (DOUT), LED86.4-DIN (DIN)
unnamed: LED86.2-DOUT (DOUT), LED87.4-DIN (DIN)
unnamed: LED87.2-DOUT (DOUT), LED88.4-DIN (DIN)
unnamed: LED88.2-DOUT (DOUT), LED89.4-DIN (DIN)
unnamed: LED89.2-DOUT (DOUT), LED90.4-DIN (DIN)
unnamed: LED90.2-DOUT (DOUT), LED91.4-DIN (DIN)
unnamed: LED91.2-DOUT (DOUT), LED92.4-DIN (DIN)
unnamed: LED92.2-DOUT (DOUT), LED93.4-DIN (DIN)
unnamed: LED93.2-DOUT (DOUT), LED94.4-DIN (DIN)
unnamed: LED94.2-DOUT (DOUT), LED95.4-DIN (DIN)
unnamed: LED95.2-DOUT (DOUT), LED96.4-DIN (DIN)
unnamed: LED97.2-DOUT (DOUT), LED98.4-DIN (DIN)
unnamed: LED98.2-DOUT (DOUT), LED99.4-DIN (DIN)
unnamed: LED99.2-DOUT (DOUT), LED100.4-DIN (DIN)
unnamed: LED100.2-DOUT (DOUT), LED101.4-DIN (DIN)
unnamed: LED101.2-DOUT (DOUT), LED102.4-DIN (DIN)
unnamed: LED102.2-DOUT (DOUT), LED103.4-DIN (DIN)
unnamed: LED103.2-DOUT (DOUT), LED104.4-DIN (DIN)
unnamed: LED104.2-DOUT (DOUT), LED105.4-DIN (DIN)
unnamed: LED105.2-DOUT (DOUT), LED106.4-DIN (DIN)
unnamed: LED106.2-DOUT (DOUT), LED107.4-DIN (DIN)
unnamed: LED107.2-DOUT (DOUT), LED108.4-DIN (DIN)
unnamed: LED109.2-DOUT (DOUT), LED110.4-DIN (DIN)
unnamed: LED110.2-DOUT (DOUT), LED111.4-DIN (DIN)
unnamed: LED111.2-DOUT (DOUT), LED112.4-DIN (DIN)
unnamed: LED112.2-DOUT (DOUT), LED113.4-DIN (DIN)
unnamed: LED113.2-DOUT (DOUT), LED114.4-DIN (DIN)
unnamed: LED114.2-DOUT (DOUT), LED115.4-DIN (DIN)
unnamed: LED115.2-DOUT (DOUT), LED116.4-DIN (DIN)
unnamed: LED116.2-DOUT (DOUT), LED117.4-DIN (DIN)
unnamed: LED117.2-DOUT (DOUT), LED118.4-DIN (DIN)
unnamed: LED118.2-DOUT (DOUT), LED119.4-DIN (DIN)
unnamed: LED119.2-DOUT (DOUT), LED120.4-DIN (DIN)
unnamed: LED121.2-DOUT (DOUT), LED122.4-DIN (DIN)
unnamed: LED122.2-DOUT (DOUT), LED123.4-DIN (DIN)
unnamed: LED123.2-DOUT (DOUT), LED124.4-DIN (DIN)
unnamed: LED124.2-DOUT (DOUT), LED125.4-DIN (DIN)
unnamed: LED125.2-DOUT (DOUT), LED126.4-DIN (DIN)
unnamed: LED126.2-DOUT (DOUT), LED127.4-DIN (DIN)
unnamed: LED127.2-DOUT (DOUT), LED128.4-DIN (DIN)
unnamed: LED128.2-DOUT (DOUT), LED129.4-DIN (DIN)
unnamed: LED129.2-DOUT (DOUT), LED130.4-DIN (DIN)
unnamed: LED130.2-DOUT (DOUT), LED131.4-DIN (DIN)
unnamed: LED131.2-DOUT (DOUT), LED132.4-DIN (DIN)
unnamed: LED133.2-DOUT (DOUT), LED134.4-DIN (DIN)
unnamed: LED134.2-DOUT (DOUT), LED135.4-DIN (DIN)
unnamed: LED135.2-DOUT (DOUT), LED136.4-DIN (DIN)
unnamed: LED136.2-DOUT (DOUT), LED137.4-DIN (DIN)
unnamed: LED137.2-DOUT (DOUT), LED138.4-DIN (DIN)
unnamed: LED138.2-DOUT (DOUT), LED139.4-DIN (DIN)
unnamed: LED139.2-DOUT (DOUT), LED140.4-DIN (DIN)
unnamed: LED140.2-DOUT (DOUT), LED141.4-DIN (DIN)
unnamed: LED141.2-DOUT (DOUT), LED142.4-DIN (DIN)
unnamed: LED142.2-DOUT (DOUT), LED143.4-DIN (DIN)
unnamed: LED143.2-DOUT (DOUT), LED144.4-DIN (DIN)
unnamed: LED12.2-DOUT (DOUT), LED13.4-DIN (DIN)
unnamed: LED24.2-DOUT (DOUT), LED25.4-DIN (DIN)
unnamed: LED36.2-DOUT (DOUT), LED37.4-DIN (DIN)
unnamed: LED48.2-DOUT (DOUT), LED49.4-DIN (DIN)
unnamed: LED60.2-DOUT (DOUT), LED61.4-DIN (DIN)
unnamed: LED72.2-DOUT (DOUT), LED73.4-DIN (DIN)
unnamed: LED84.2-DOUT (DOUT), LED85.4-DIN (DIN)
unnamed: LED96.2-DOUT (DOUT), LED97.4-DIN (DIN)
unnamed: LED108.2-DOUT (DOUT), LED109.4-DIN (DIN)
unnamed: LED120.2-DOUT (DOUT), LED121.4-DIN (DIN)
unnamed: LED132.2-DOUT (DOUT), LED133.4-DIN (DIN)
unnamed: LED1.4-DIN (DIN), R6.2
VCC: C26.2, C27.+, C28.+, LED1.1-VDD (VDD), LED2.1-VDD (VDD), LED3.1-VDD (VDD), LED4.1-VDD (VDD), LED5.1-VDD (VDD), LED6.1-VDD (VDD), LED7.1-VDD (VDD), LED8.1-VDD (VDD), LED9.1-VDD (VDD), LED10.1-VDD (VDD), LED11.1-VDD (VDD), LED12.1-VDD (VDD), LED13.1-VDD (VDD), LED14.1-VDD (VDD), LED15.1-VDD (VDD), LED16.1-VDD (VDD), LED17.1-VDD (VDD), LED18.1-VDD (VDD), LED19.1-VDD (VDD), LED20.1-VDD (VDD), LED21.1-VDD (VDD), LED22.1-VDD (VDD), LED23.1-VDD (VDD), LED24.1-VDD (VDD), LED25.1-VDD (VDD), LED26.1-VDD (VDD), LED27.1-VDD (VDD), LED28.1-VDD (VDD), LED29.1-VDD (VDD), LED30.1-VDD (VDD), LED31.1-VDD (VDD), LED32.1-VDD (VDD), LED33.1-VDD (VDD), LED34.1-VDD (VDD), LED35.1-VDD (VDD), LED36.1-VDD (VDD), LED37.1-VDD (VDD), LED38.1-VDD (VDD), LED39.1-VDD (VDD), LED40.1-VDD (VDD), LED41.1-VDD (VDD), LED42.1-VDD (VDD), LED43.1-VDD (VDD), LED44.1-VDD (VDD), LED45.1-VDD (VDD), LED46.1-VDD (VDD), LED47.1-VDD (VDD), LED48.1-VDD (VDD), LED49.1-VDD (VDD), LED50.1-VDD (VDD), LED51.1-VDD (VDD), LED52.1-VDD (VDD), LED53.1-VDD (VDD), LED54.1-VDD (VDD), LED55.1-VDD (VDD), LED56.1-VDD (VDD), LED57.1-VDD (VDD), LED58.1-VDD (VDD), LED59.1-VDD (VDD), LED60.1-VDD (VDD), LED61.1-VDD (VDD), LED62.1-VDD (VDD), LED63.1-VDD (VDD), LED64.1-VDD (VDD), LED65.1-VDD (VDD), LED66.1-VDD (VDD), LED67.1-VDD (VDD), LED68.1-VDD (VDD), LED69.1-VDD (VDD), LED70.1-VDD (VDD), LED71.1-VDD (VDD), LED72.1-VDD (VDD), LED73.1-VDD (VDD), LED74.1-VDD (VDD), LED75.1-VDD (VDD), LED76.1-VDD (VDD), LED77.1-VDD (VDD), LED78.1-VDD (VDD), LED79.1-VDD (VDD), LED80.1-VDD (VDD), LED81.1-VDD (VDD), LED82.1-VDD (VDD), LED83.1-VDD (VDD), LED84.1-VDD (VDD), LED85.1-VDD (VDD), LED86.1-VDD (VDD), LED87.1-VDD (VDD), LED88.1-VDD (VDD), LED89.1-VDD (VDD), LED90.1-VDD (VDD), LED91.1-VDD (VDD), LED92.1-VDD (VDD), LED93.1-VDD (VDD), LED94.1-VDD (VDD), LED95.1-VDD (VDD), LED96.1-VDD (VDD), LED97.1-VDD (VDD), LED98.1-VDD (VDD), LED99.1-VDD (VDD), LED100.1-VDD (VDD), LED101.1-VDD (VDD), LED102.1-VDD (VDD), LED103.1-VDD (VDD), LED104.1-VDD (VDD), LED105.1-VDD (VDD), LED106.1-VDD (VDD), LED107.1-VDD (VDD), LED108.1-VDD (VDD), LED109.1-VDD (VDD), LED110.1-VDD (VDD), LED111.1-VDD (VDD), LED112.1-VDD (VDD), LED113.1-VDD (VDD), LED114.1-VDD (VDD), LED115.1-VDD (VDD), LED116.1-VDD (VDD), LED117.1-VDD (VDD), LED118.1-VDD (VDD), LED119.1-VDD (VDD), LED120.1-VDD (VDD), LED121.1-VDD (VDD), LED122.1-VDD (VDD), LED123.1-VDD (VDD), LED124.1-VDD (VDD), LED125.1-VDD (VDD), LED126.1-VDD (VDD), LED127.1-VDD (VDD), LED128.1-VDD (VDD), LED129.1-VDD (VDD), LED130.1-VDD (VDD), LED131.1-VDD (VDD), LED132.1-VDD (VDD), LED133.1-VDD (VDD), LED134.1-VDD (VDD), LED135.1-VDD (VDD), LED136.1-VDD (VDD), LED137.1-VDD (VDD), LED138.1-VDD (VDD), LED139.1-VDD (VDD), LED140.1-VDD (VDD), LED141.1-VDD (VDD), LED142.1-VDD (VDD), LED143.1-VDD (VDD), LED144.1-VDD (VDD), U4.2 (OUT)
VIN: U4.1 (IN); also elsewhere on the board
