thecolonel999/Word-Clock/Eagle/Word-Clock.brd

## EAGLE design Eagle/Word-Clock.brd (continued)

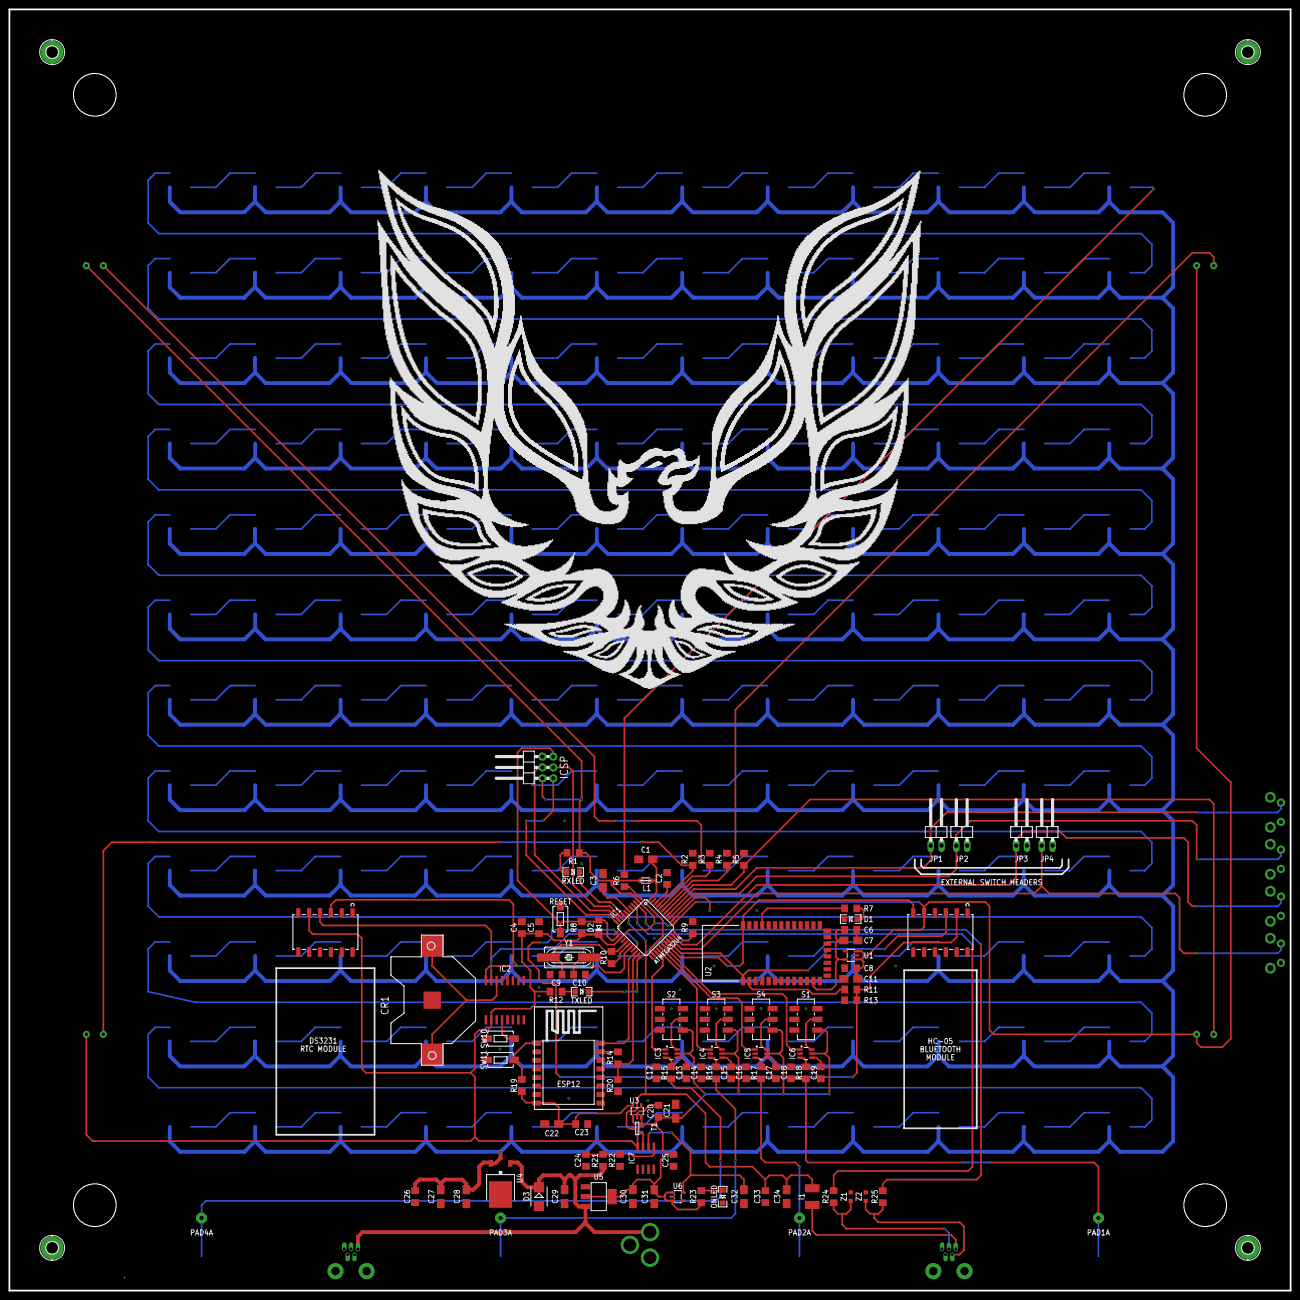
[picture p27: board Word-Clock.brd from above]

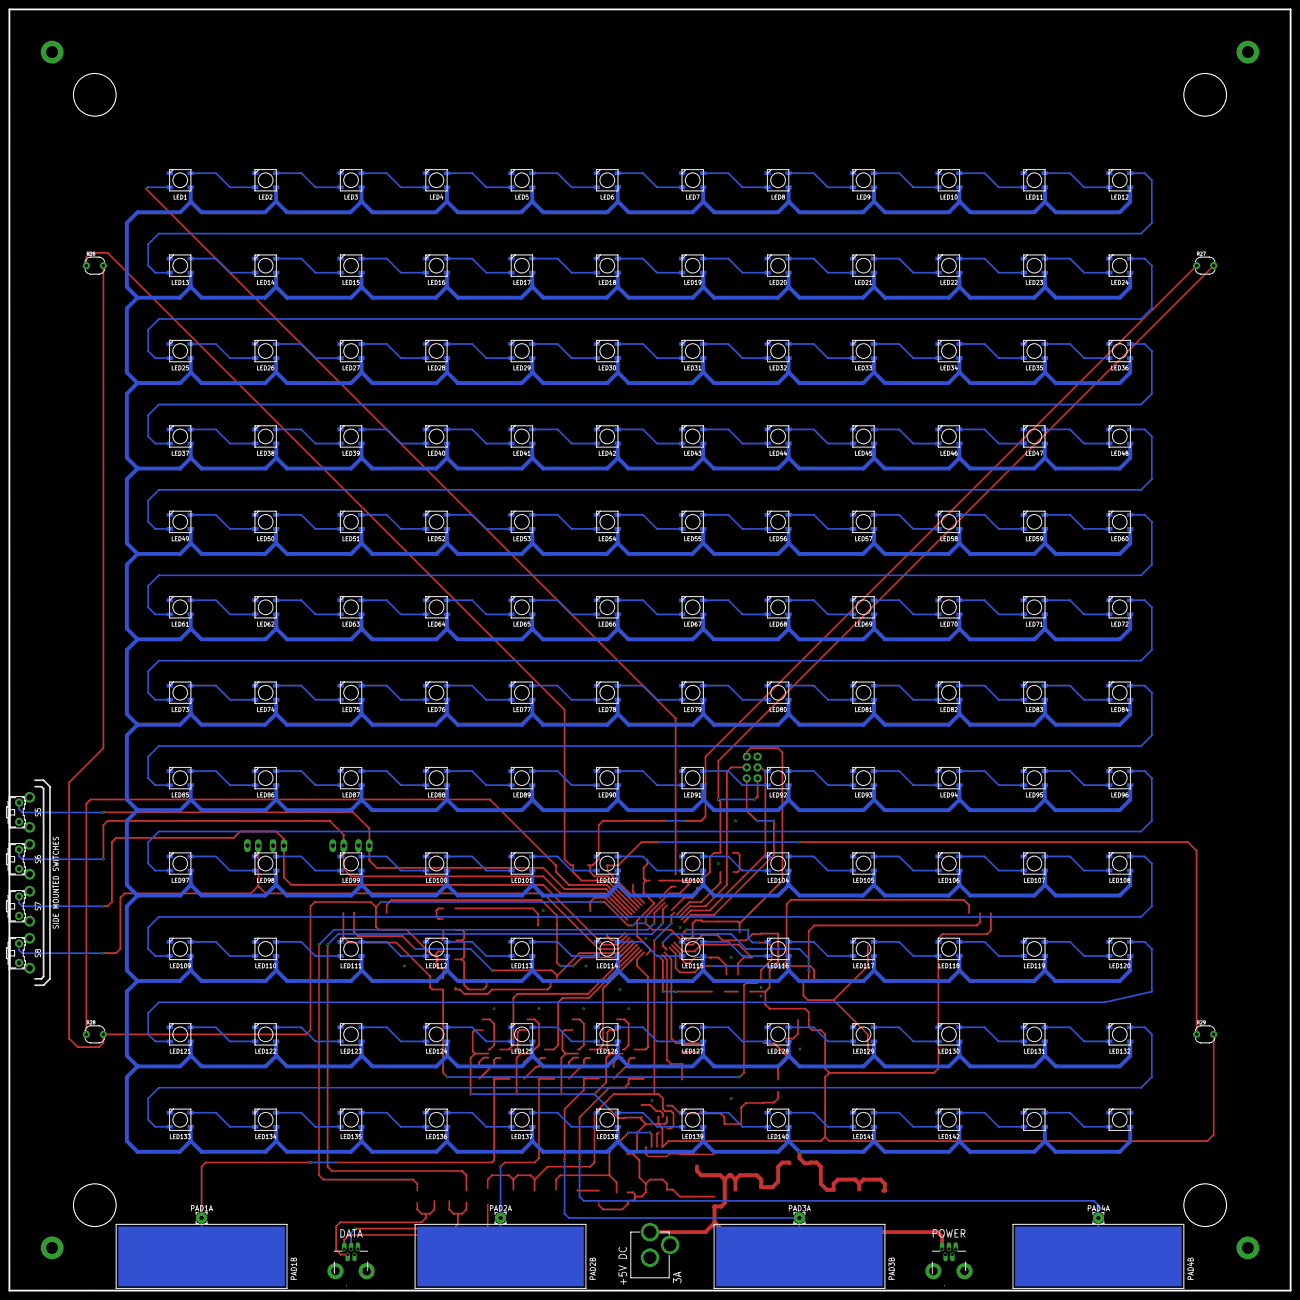
[picture p28: board Word-Clock.brd from below]

Board: 2 copper layers, 300.0 x 300.0 mm, 268 parts (163 on the bottom side), 217 nets.

Other parts of the board:
U$1: FIREBIRD2
