thecolonel999/Word-Clock/Arduino/Word-Clock/LANGUAGE_English_v1.h

/*
 * Clock_v1 faceplate file
 * 
 * 
 *  Author: David Sanders
 *  Licence: http://creativecommons.org/licenses/by/3.0/
 *  Description:
 *    30 x 30 Word clock in English
 * 
 *    0 1 2 3 4 5 6 7 8 91011
 *  0 I T   I S   T W E N T Y
 *  1 T W O N E Q U A R T E R
 *  2 E L E V E N T W E L V E
 *  3 T E N S E V E N T H I R
 *  4 T H R E E S I X N I N E
 *  5 F O U R E I G H T E E N
 *  6 H A L F I V E   P A S T
 *  7 T O   T H R E E N I N E
 *  8 O N E L E V E N F I V E
 *  9 F O U R T W O S E V E N
 * 10 T E N T W E L V E S I X
 * 11 E I G H T   O C L O C K
 */

const uint8_t WORDS_min[] PROGMEM = {   // minute words
  23,        //# words
	0, 0, 2,   //it
  0, 3, 2,   //is
  1, 2, 3,   //one
  1, 0, 3,   //two
  4, 0, 5,   //three
  5, 0, 4,   //four
  6, 3, 4,   //five
  4, 5, 3,   //six
  3, 3, 5,   //seven
  5, 4, 5,   //eight
  4, 8, 4,   //nine
  3, 0, 3,   //ten
  2, 0, 6,   //eleven
  2, 6, 6,   //twelve
  3, 8, 4,   //thir
  1, 5, 7,   //quarter
  5, 4, 8,   //eighteen
  5, 8, 4,   //teen
  0, 6, 6,   //twenty
  6, 6, 4,   //half
  6, 8, 4,   //past
  7, 0, 2,   //to
  11, 6, 6,  //oclock
};


const uint8_t DISPLAY_min[] PROGMEM = {
   3, 			 // number of bytes per state
//	    sffttoii  qttetnes  otphtte
  0b00000011,  0b00000000,  0b01000000,       //xx:00
  0b00000111,  0b00000000,  0b00010000,       //xx:01
  0b00001011,  0b00000000,  0b00010000,       //xx:02
  0b00010011,  0b00000000,  0b00010000,       //xx:03
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
	0b00100000,  0b00000000,     //17:xx
	0b01000000,  0b00000000,     //18:xx
	0b10000000,  0b00000000,     //19:xx
	0b00000000,  0b00000001,     //20:xx
	0b00000000,  0b00000010,     //21:xx
	0b00000000,  0b00000100,     //22:xx
	0b00000000,  0b00001000,     //23:xx
};
