thecolonel999/Word-Clock/(commit log)

2015-10-07 First Iteration of Arduino Code
2015-10-07 Schematic V1.0
    [Arduino_Micro_Rev03j.brd, Arduino_Micro_Rev03j.sch, Word-Clock.sch]
2015-10-07 Schematic & PCB V1.1
    [Word-Clock.brd, Word-Clock.sch]
2015-10-07 Schematic & PCB V1.2
    [Word-Clock.brd, Word-Clock.sch]
2015-10-08 New Code
    [LANGUAGE layout helper.xlsx]
2015-10-09 Updated BOM
    [Word-Clock-BOM.xlsx]
2015-10-14 Power Consumption Calculations
    [230mm Divider.skp, 300mm Divider.skp, Operating Cost Calcs.xlsx, Word-Clock V1.1.sch, Word-Clock-BOM.xlsx, Word-Clock.brd, Word-Clock.sch]
2015-10-21 V1.2 PCB
    [Arduino_Micro_Rev03j.brd, Arduino_Micro_Rev03j.sch, Operating Cost Calcs.xlsx, Word-Clock V1.1.sch, Word-Clock.brd, Word-Clock.sch]
2015-10-30 V1.3 PCB
    [300mm Divider (no side switches).skp, 300mm Divider (no side switches)~.skp, 300mm Divider.skp, 300mm Divider~.skp, Back Panel.skp, Glass.skp, Word-Clock-BOM.csv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]
