thecolonel999/Word-Clock/(notices)

Notices in the files:
parts and their libraries:
SparkFun-LED: Licensing: Creative Commons ShareAlike 4.0 International - https://creativecommons.org/licenses/by-sa/4.0
switch-ck: Copyright (C) 2011, Bob Starr
